fyulita/laboratorio-6-y-7/presentacion-Labo6.pdf

# Desarrollo de un sistema respirométrico para determinar la biodegradabilidad en compost

## Federico Yulita y Carolina Iacovone

## Directores Dr. Lucas Guz y Dra. Lucía Famá

## Presentación final de Laboratorio 6

### Laboratorio de Polímeros y Materiales Compuestos

Laboratorio VI

Introducción

Propuesta

Desarrollo

Prueba

Conclusiones

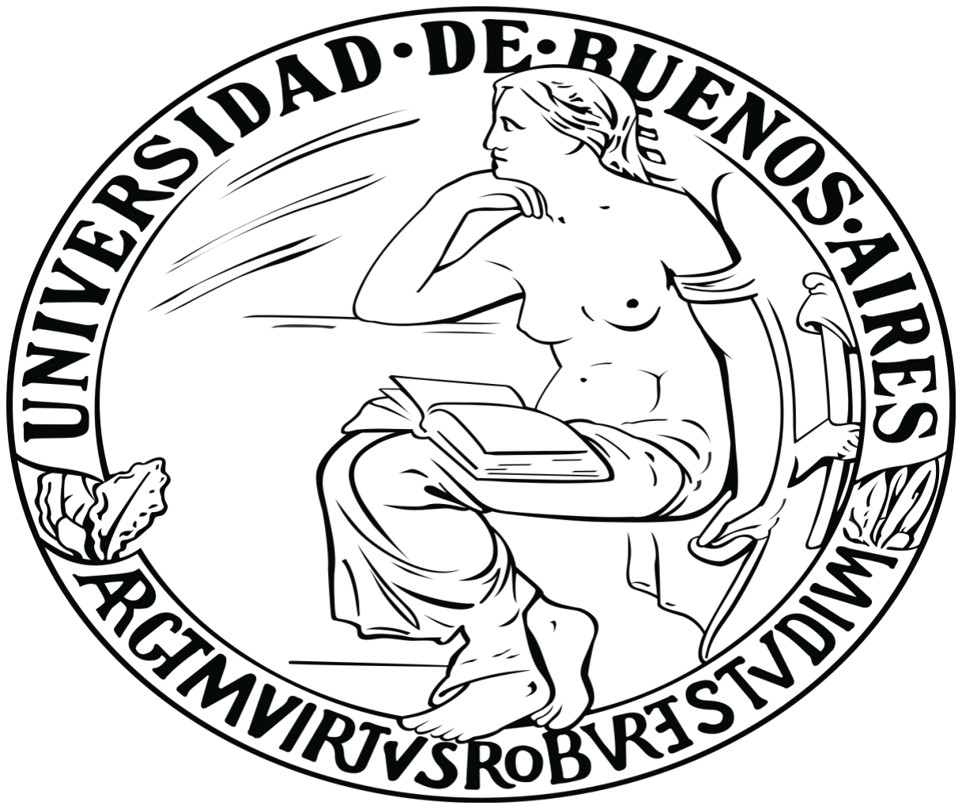
[picture p28: figure]
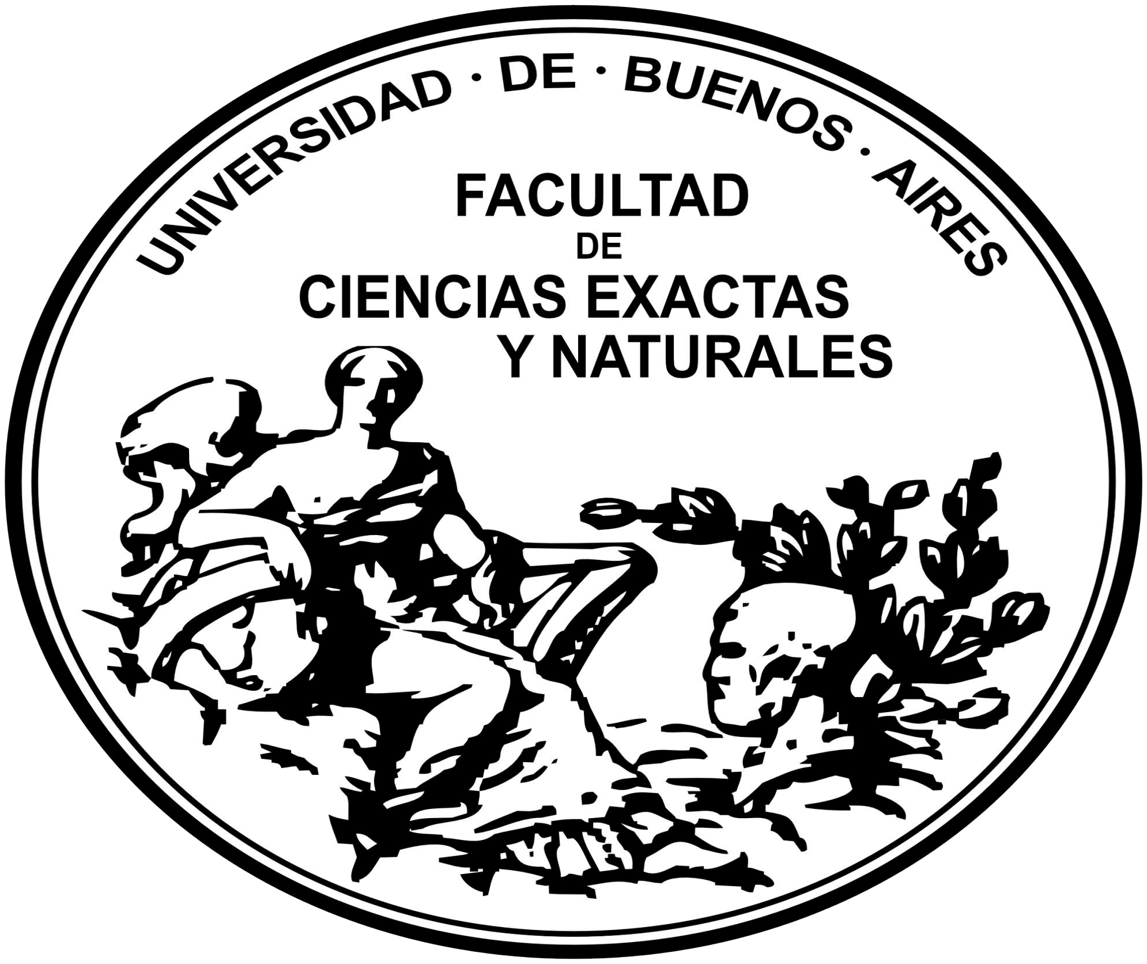
[picture p29: figure]
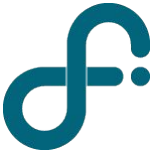
[picture p30: figure]

Introducción

Propuesta

Desarrollo

Prueba

Conclusiones

## Plásticos: problemática a escala mundial

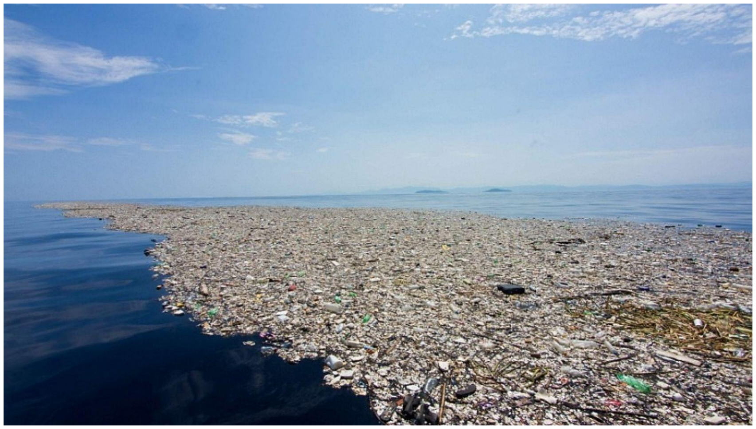
[picture p31: figure]

Isla de plásticos en el océano pacífico

Definición de polímero biodegradable¹
:
polímero susceptible a degradación mediante actividad biológica, acompañada por una disminución del peso molecular.

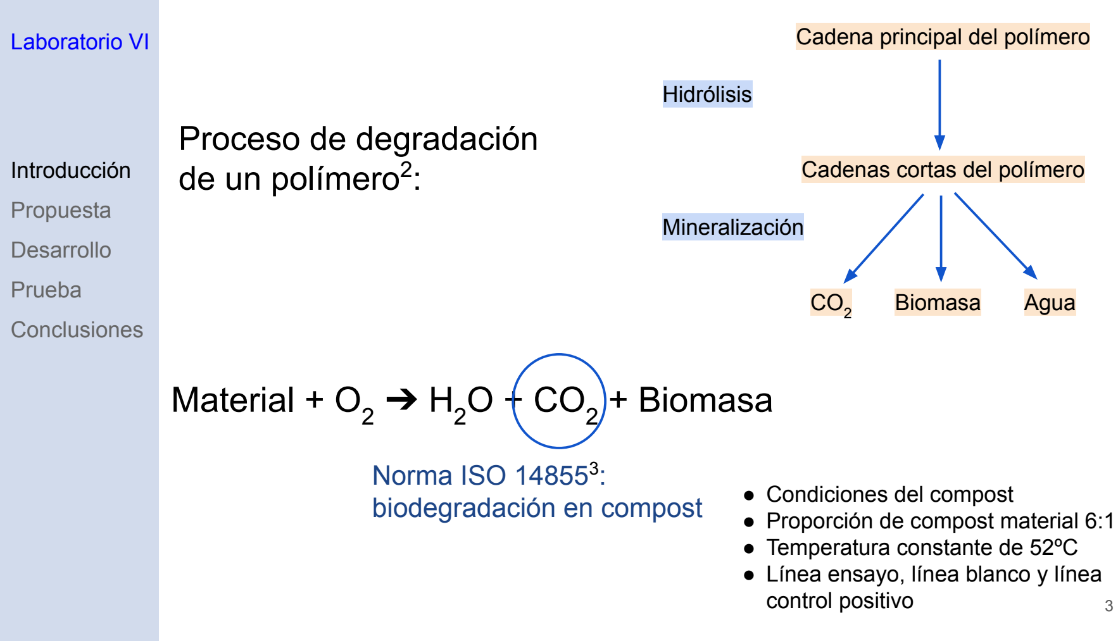
[picture p32: figure]
Introducción; Propuesta; Desarrollo; Prueba; Conclusiones; Cadena principal del polímero; Cadenas cortas del polímero; Biomasa; Agua; Hidrólisis; Mineralización; Proceso de degradación de un polímero² :; Material + O2 ➔ H2O + CO2; + Biomasa; Norma ISO 14855³; ● Proporción de compost material 6:1 ● Temperatura constante de 52ºC ● Línea ensayo, línea blanco y línea control positivo

### biodegradación en compost ● Condiciones del compost

Introducción

Propuesta

Desarrollo

Prueba

Conclusiones

Finalmente, un material es biodegradable si alcanza el 90% de la biodegradación del material en hasta 6 meses.⁴

## Objetivo: diseñar, fabricar y poner a punto un equipo capaz

de estudiar la biodegradabilidad de polímeros en compost.

Contexto actual en Argentina:
Se comercializan productos biodegradables → necesidad de una evaluación

## Serie Referencia

## Propuesta

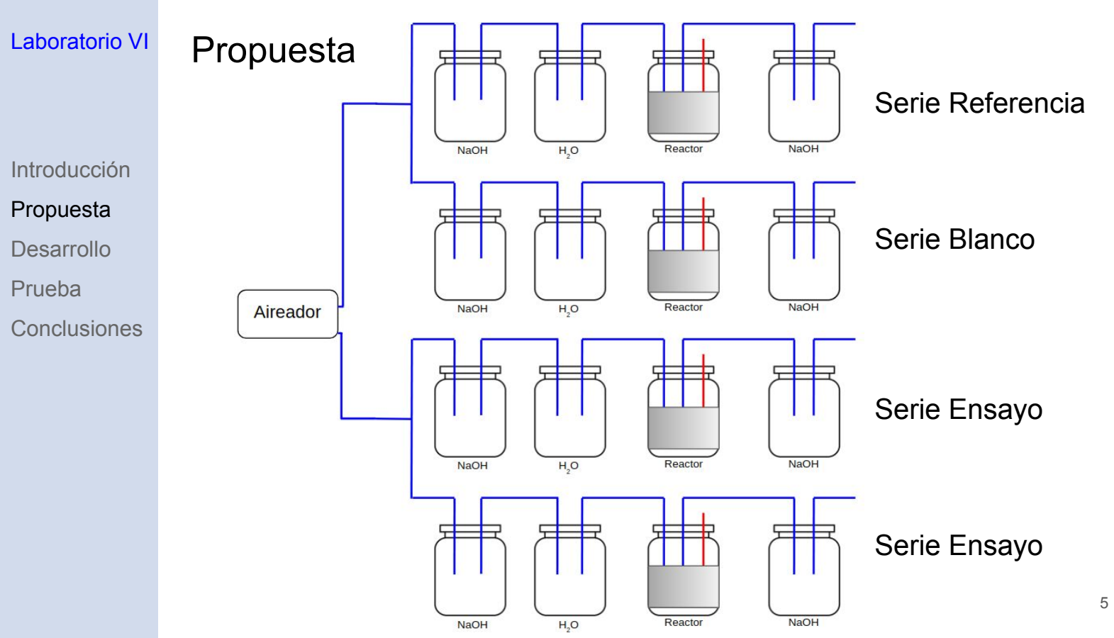
[picture p33: page 5]

Introducción

Propuesta

Desarrollo

Prueba

Conclusiones

## Serie Blanco

## Serie Ensayo

## Serie Ensayo

Introducción

Propuesta

Desarrollo

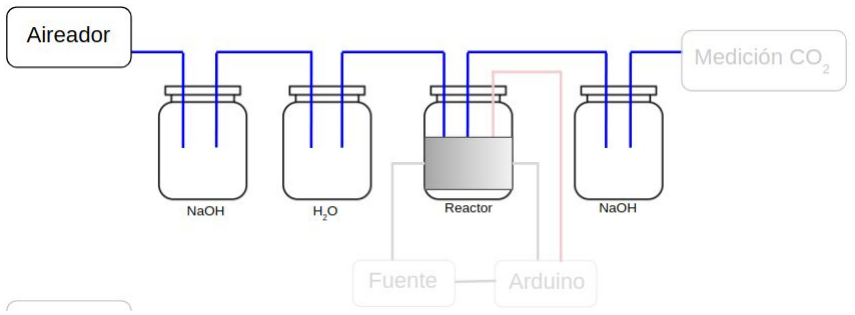
[picture p34: figure]

Prueba

Conclusiones

# Partes del equipo

- Seguimiento del aire
- Reactor
- Sistema térmico
- Medición de CO2

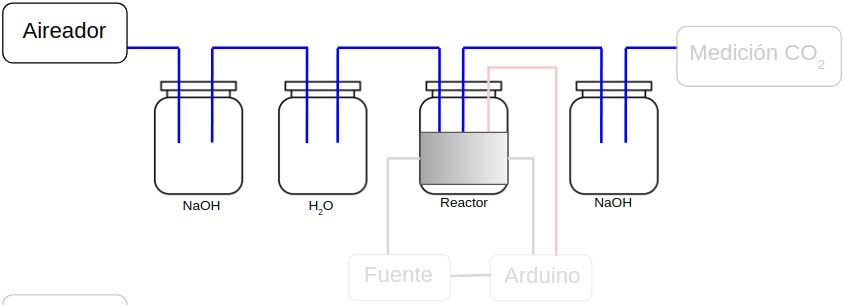
[picture p35: figure]

Introducción

Propuesta

Desarrollo

Prueba

Conclusiones

Seguimiento del aire

Introducción

Propuesta

Desarrollo

Prueba

Conclusiones

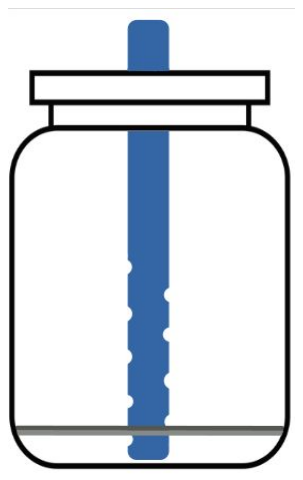
[picture p36: figure]
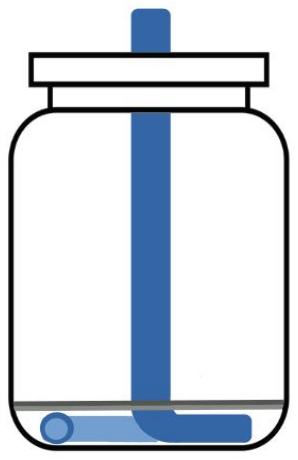
[picture p37: figure]

Configuración 1: agujeros en la manguera | Configuración 2: manguera formando un círculo en el fondo

Al Frasco de vidrio Schott se le colocaron piedritas en el fondo y dos mallas tipo mosquitero para hacer un colchón de aire. Luego, se realizaron 2 configuraciones para la circulación del aire:

Luego, se colocó el compost.

Reactor

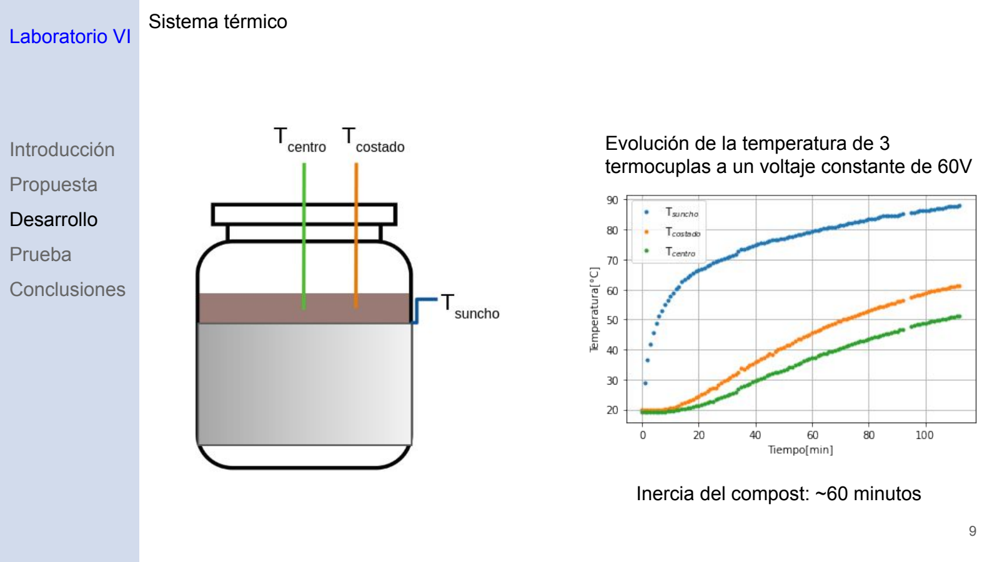
[picture p38: page 9]

Introducción

Propuesta

Desarrollo

Prueba

Conclusiones

Evolución de la temperatura de 3 termocuplas a un voltaje constante de 60V

Inercia del compost: ~60 minutos

Sistema térmico

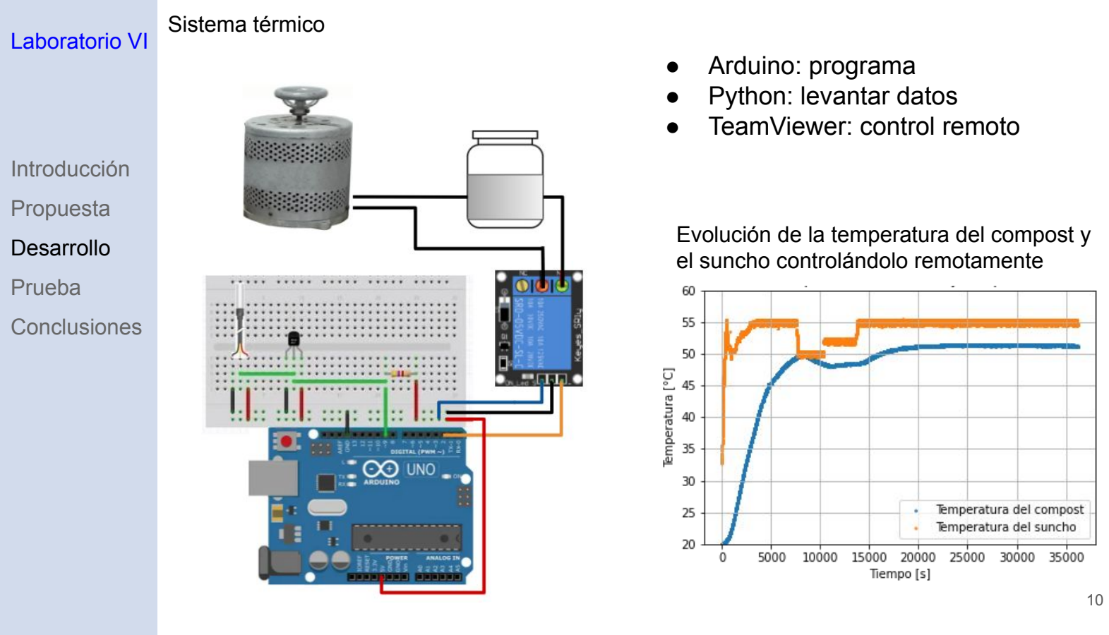
[picture p39: page 10]

Introducción

Propuesta

Desarrollo

Prueba

Conclusiones

Sistema térmico
- Arduino: programa
- Python: levantar datos
- TeamViewer: control remoto

Evolución de la temperatura del compost y el suncho controlándolo remotamente

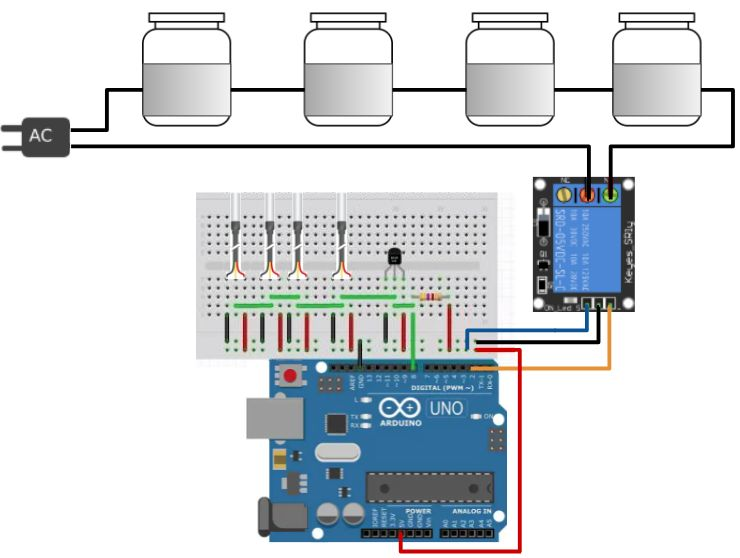
[picture p40: figure]

Introducción

Propuesta

Desarrollo

Prueba

Conclusiones

Sistema térmico: completo

## Equipo finalizado

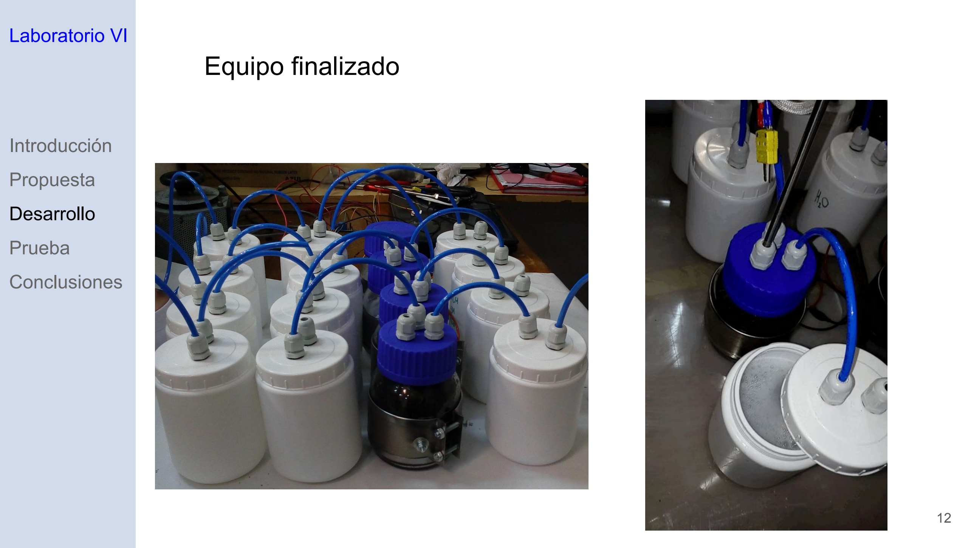
[picture p41: page 12]

Introducción

Propuesta

Desarrollo

Prueba

Conclusiones

## : Por titulación⁵

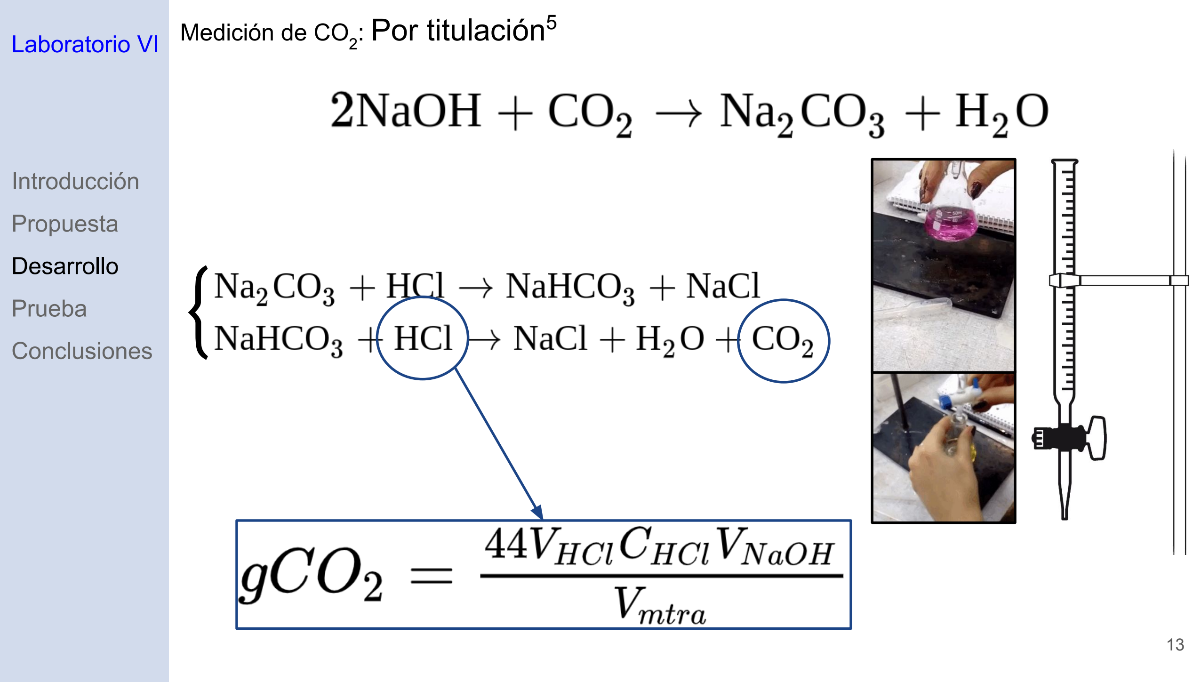
[picture p42: page 13]

Introducción

Propuesta

Desarrollo

Prueba

Conclusiones

Medición de CO2

{

Introducción

Propuesta

Desarrollo

Prueba

Conclusiones

## Puesta a punto: se realizaron dos simulaciones

## - Simulación con bicarbonato de sodio

Se simuló al compost con una solución de bicarbonato de sodio, esperando que se produzcan 1.78g de CO2
La trampa de NaOH capturó 0.4mL, es decir 1.40g de CO2

## - Simulación con pasto

Se colocó pasto en el compost y se dejó el equipo funcionando por 24hs. La trampa de NaOH capturó 0.2mL, es decir 0.70g de CO2

Introducción

Propuesta

Desarrollo

Prueba

Conclusiones

# Conclusiones

## - Se logró monitorear y controlar la temperatura del compost de

manera remota.

## - Las configuraciones de la manguera no presentaron diferencias

significativas.

## - Las simulaciones de captura de CO2

resultaron exitosas.
- Se logró construir el equipo.

## Proyección: analizar la biodegradabilidad de películas de almidón elaboradas por extrusión utilizando el equipo construido en laboratorio 6

# ¡Muchas gracias!

# Bibliografía

1
IUPAC. Compendium of Chemical Terminology, 2nd ed. (the "Gold Book"). Compilado por A. D. McNaught y A. Wilkinson. Blackwell Scientific Publications, Oxford (1997). Versión online (2019-) creado por S. J. Chalk. ISBN 0-9678550-9-8. https://doi.org/10.1351/goldbook.

2E. Castro Aguirre, Design and construction of a medium-scale automated direct measurement respirometric system to assess aerobic biodegradation of polymers, Michigan State University, 2013.

3
ISO/DIS 14855-1. Determination of the Ultimate Aerobic Biodegradability and Disintegration of Plastic Materials under Controlled Composting Conditions—Method by Analysis of Evolved Carbon dioxide.

4EN 13432:2000. Packaging - Requirements for packaging recoverable through composting and biodegradation - Test scheme and evaluation criteria for the final acceptance of packaging.

5G. Kale, R. Auras, S. P. Singh, R. Narayan, Biodegradability of polylactide bottles in real and simulated composting conditions, Polymer Testing 26 (2007) 1049–1061.

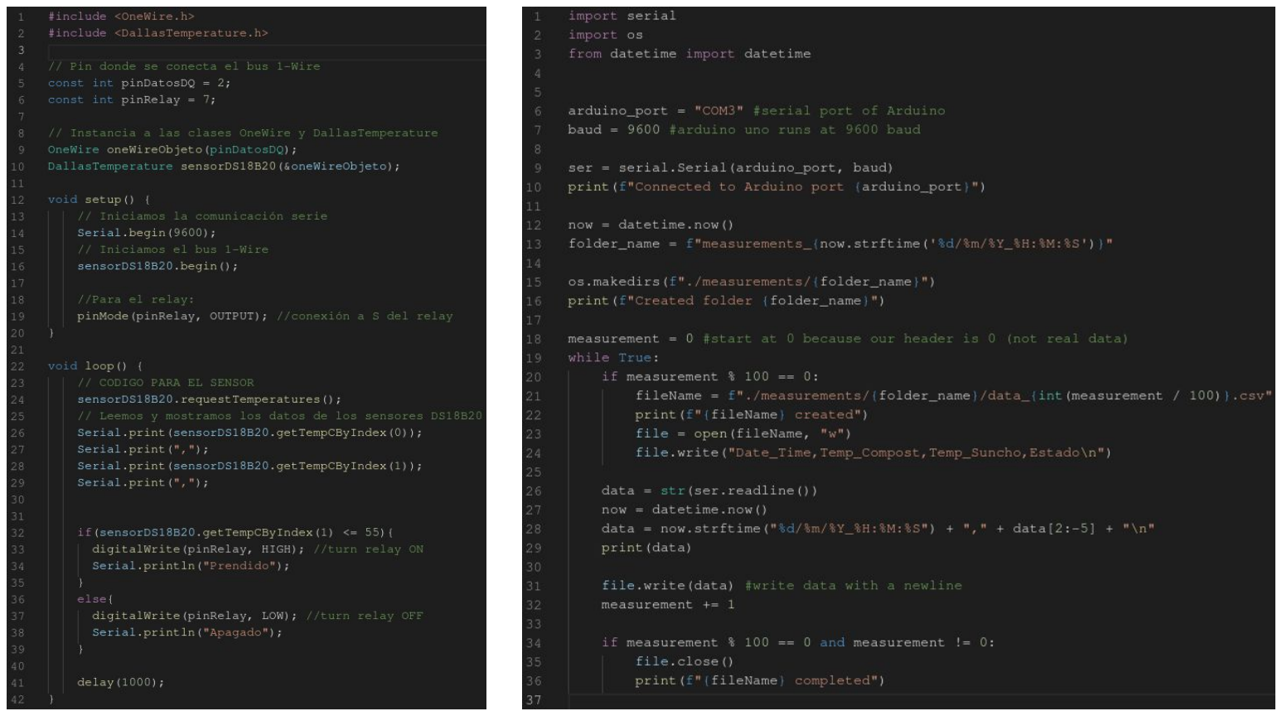
[picture p43: page 18]
