fyulita/laboratorio-6-y-7/Facturas/factura_arduino.pdf

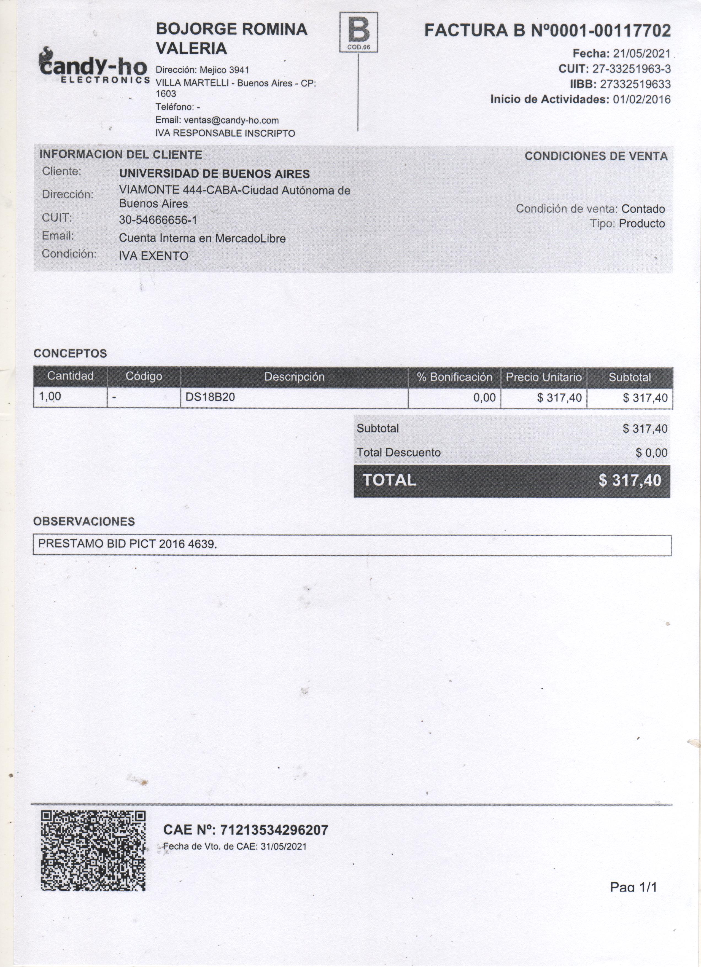
[picture p54: page 1]
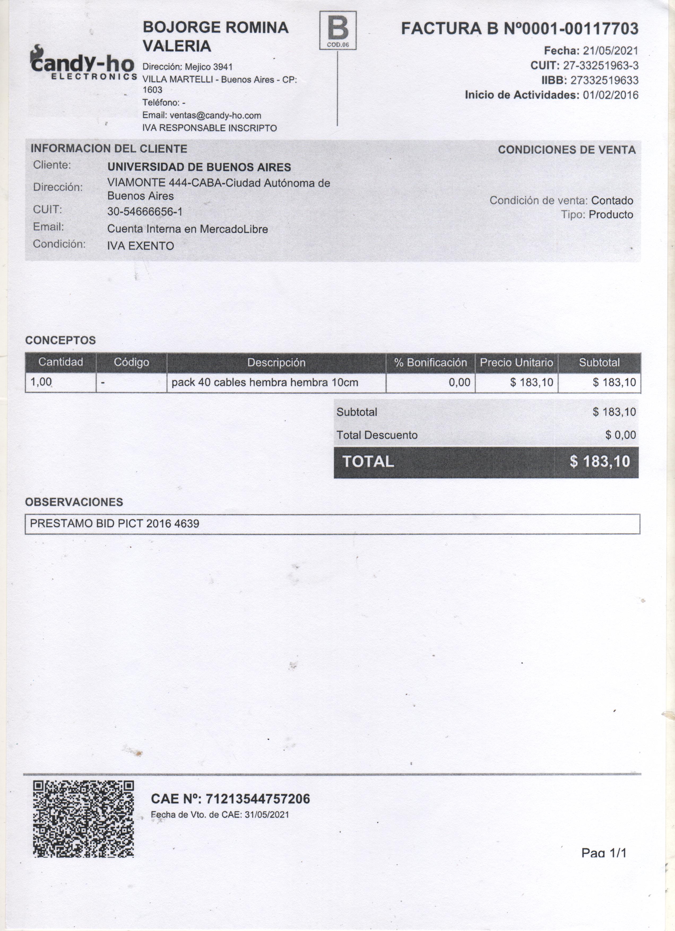
[picture p55: page 2]
