fyulita/laboratorio-6-y-7/Facturas/Frascos plastico - factura.pdf

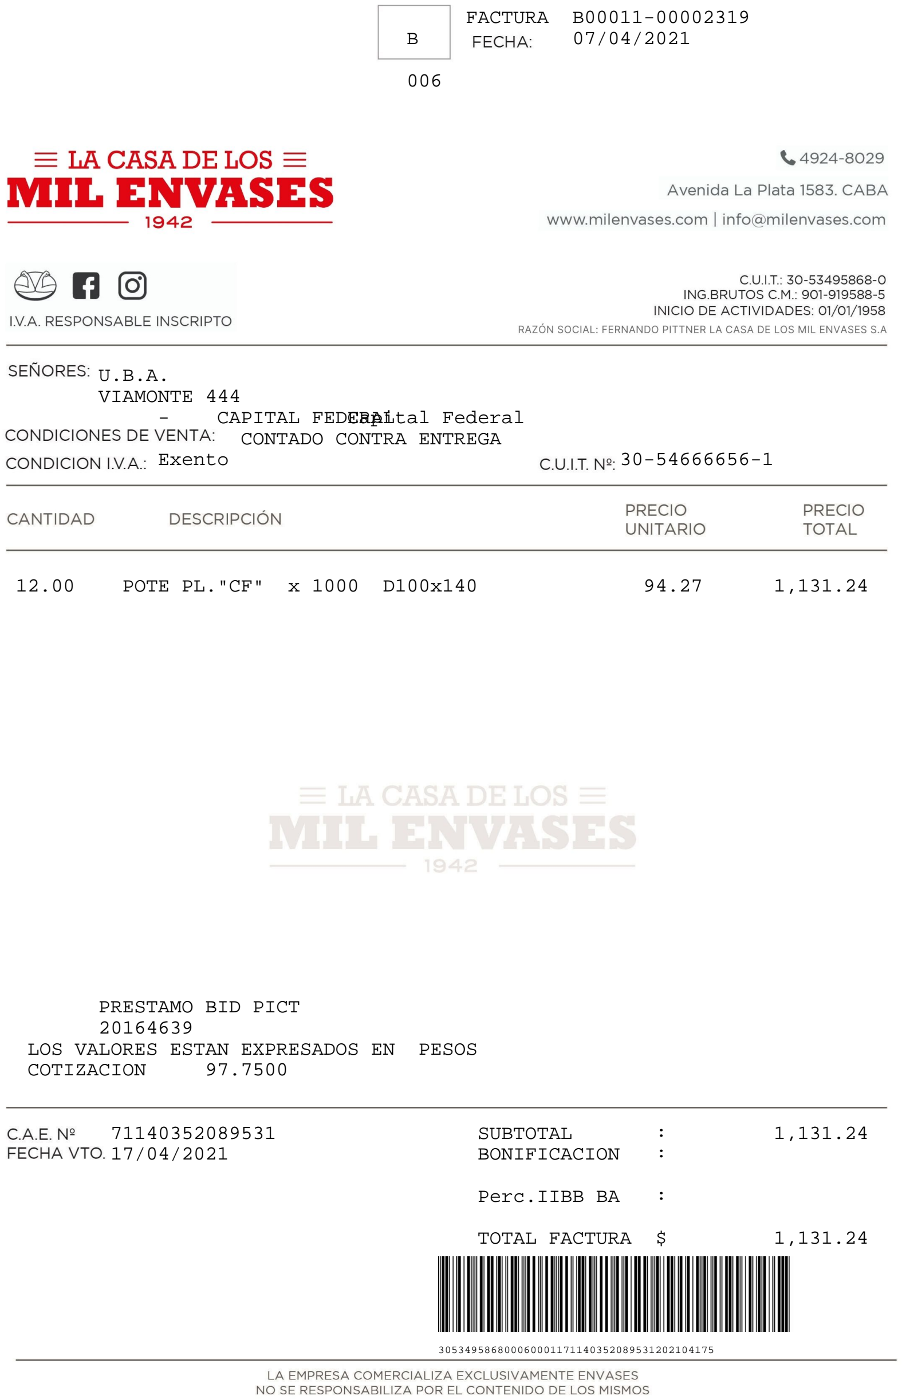
[picture p56: page 1]

FACTURA B00011-00002319
B | 07/04/2021

006

U.B.A.
VIAMONTE 444
- CAPITAL FEDECRaApLital Federal
CONTADO CONTRA ENTREGA
Exento | 30-54666656-1
12.00 | POTE PL."CF" x 1000 D100x140 | 94.27 | 1,131.24

PRESTAMO BID PICT
20164639
LOS VALORES ESTAN EXPRESADOS EN PESOS
COTIZACION | 97.7500
71140352089531 | SUBTOTAL | : | 1,131.24
17/04/2021 | BONIFICACION | :
| Perc.IIBB BA | :
TOTAL FACTURA $ | 1,131.24

305349586800060001171140352089531202104175
