fyulita/laboratorio-6-y-7/Facturas/ManguerayConcetor - Datos bancarios.pdf

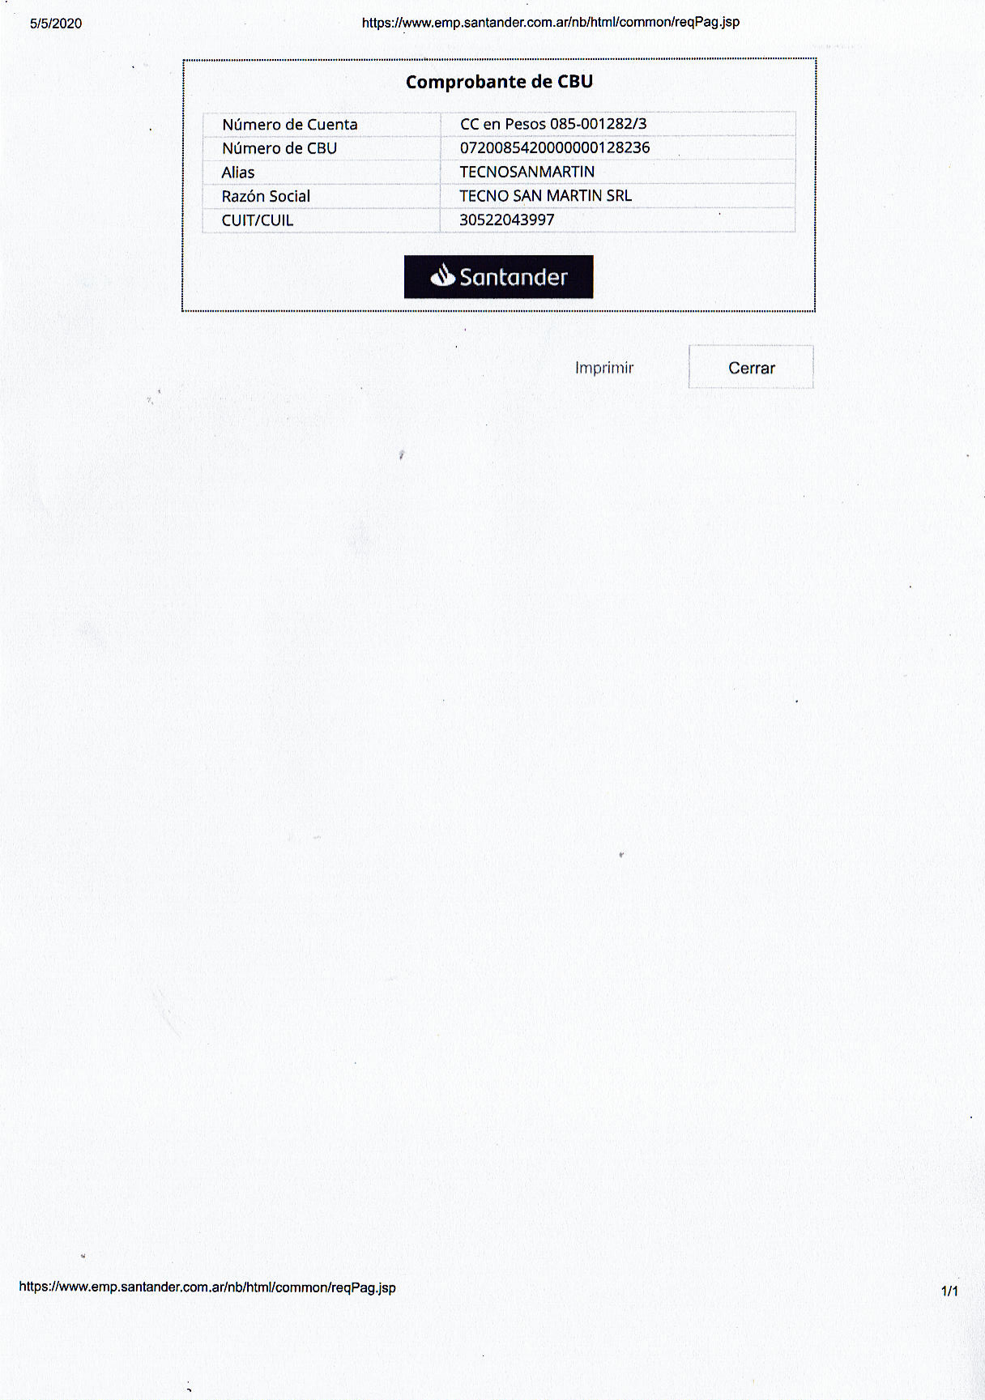
[picture p57: page 1]
