fyulita/laboratorio-6-y-7/Facturas/ManguerayConectores - Factura.pdf

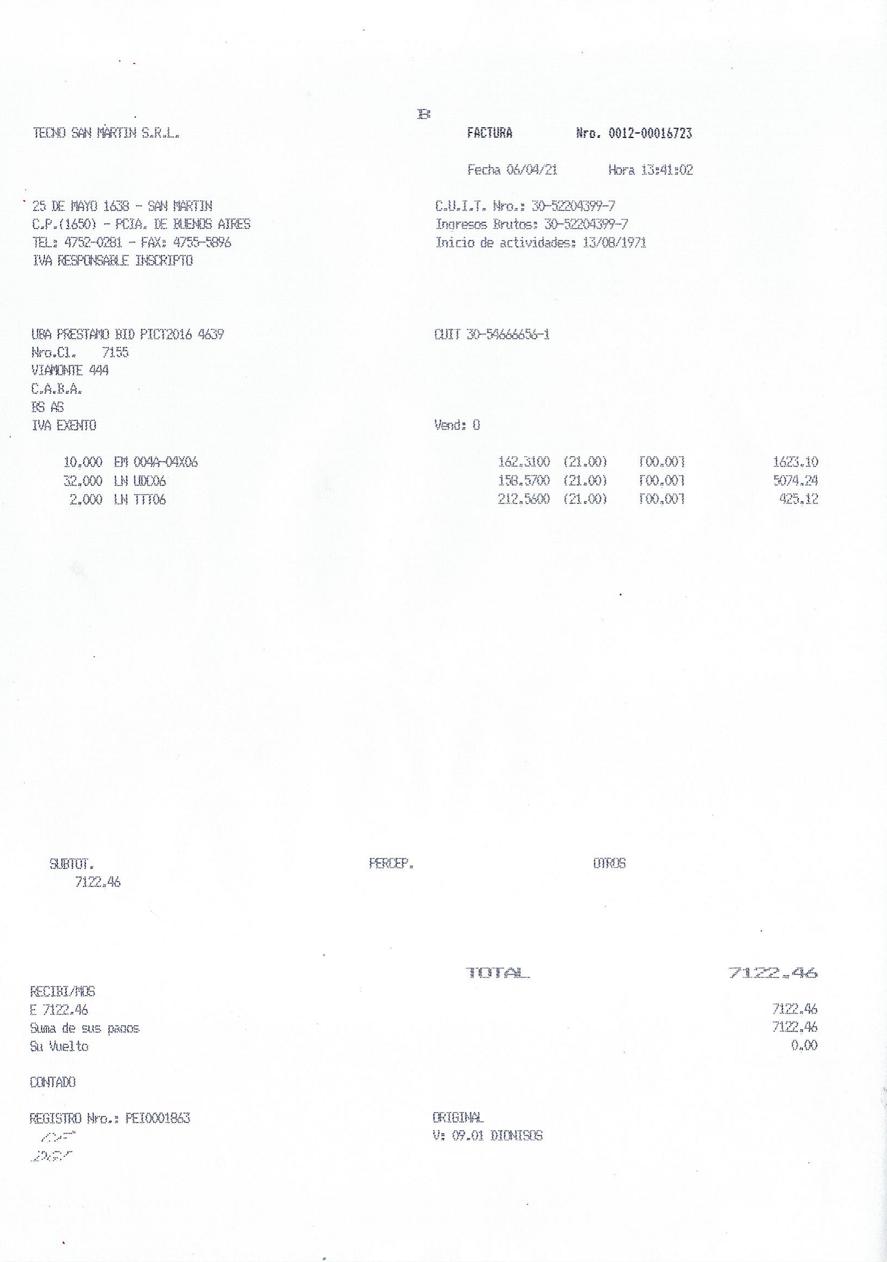
[picture p58: page 1]
