fyulita/laboratorio-6-y-7/Arduino/biodeg_sensor_primer-medicion-restado.png

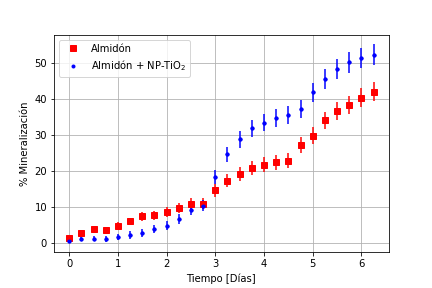
Arduino/biodeg_sensor_primer-medicion-restado.png
