fyulita/laboratorio-6-y-7/Arduino/biodeg_sensor_segunda-medicion-restado.png

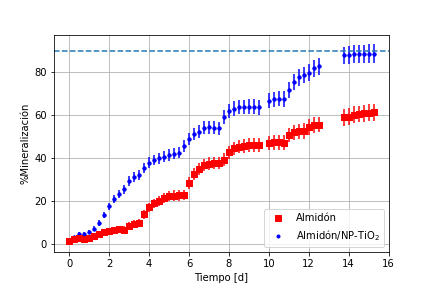
Arduino/biodeg_sensor_segunda-medicion-restado.png
