fyulita/laboratorio-6-y-7/Arduino/co2_acumulado-sensor.png

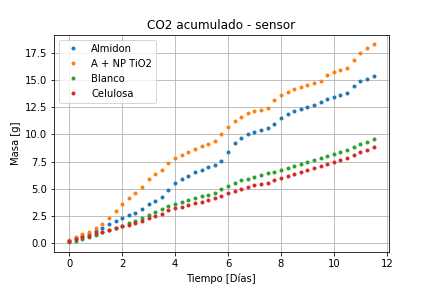
Arduino/co2_acumulado-sensor.png
