fyulita/laboratorio-6-y-7/download.png

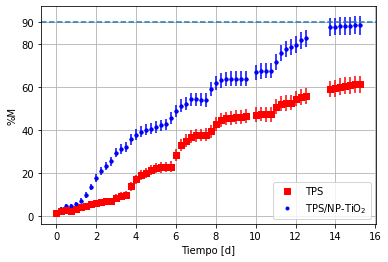
download.png
