fyulita/laboratorio-6-y-7/Imagenes/arduino2.png

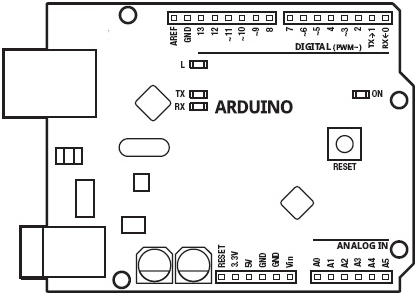
Imagenes/arduino2.png
