fyulita/laboratorio-6-y-7/Imagenes/arduino3.png

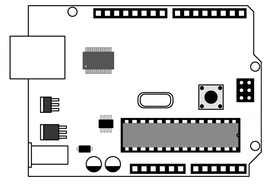
Imagenes/arduino3.png
