fyulita/laboratorio-6-y-7/Imagenes/equipo4.png

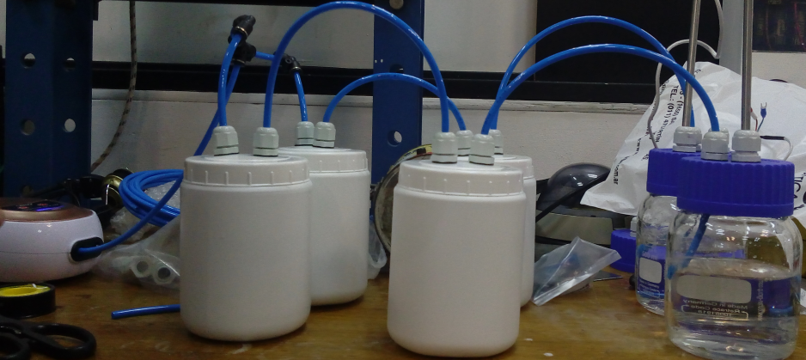
Imagenes/equipo4.png
