fyulita/laboratorio-6-y-7/Imagenes/equipo.jpeg

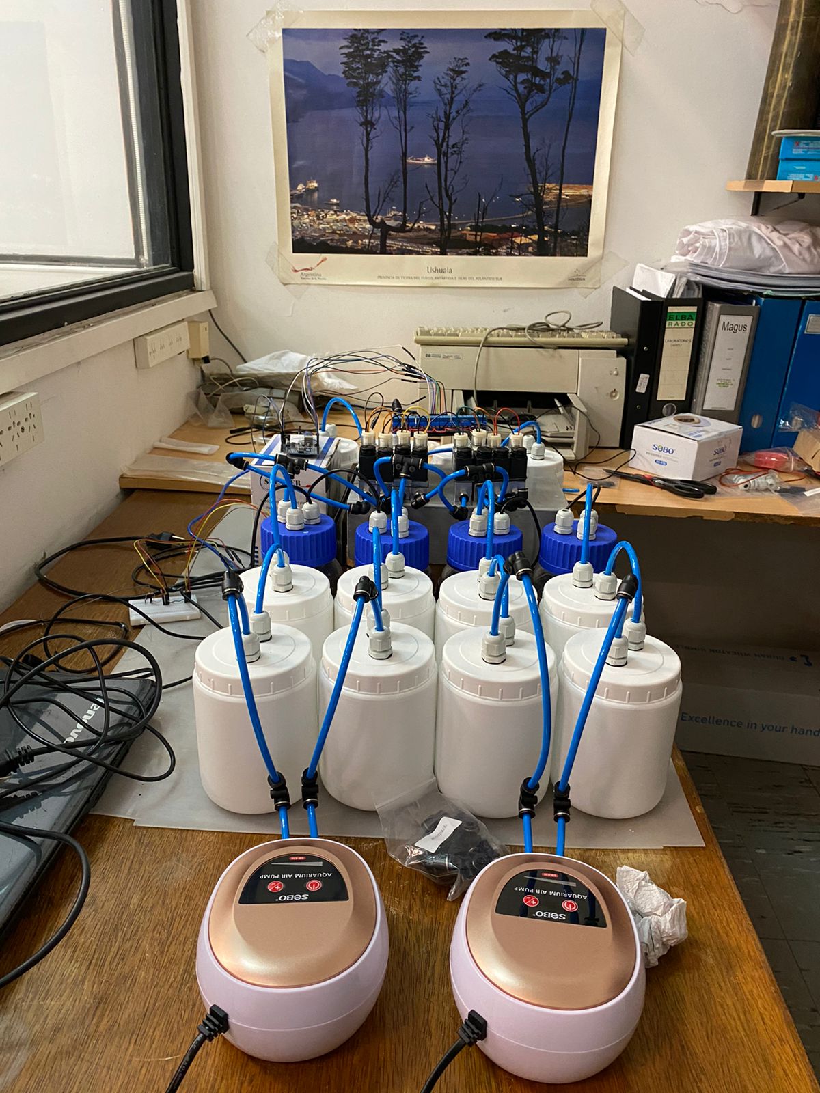
Imagenes/equipo.jpeg
