fyulita/laboratorio-6-y-7/Imagenes/esquema_5T.png

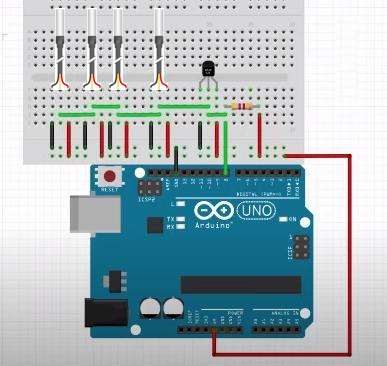
Imagenes/esquema_5T.png
