fyulita/laboratorio-6-y-7/Imagenes/esquema_reactor.png

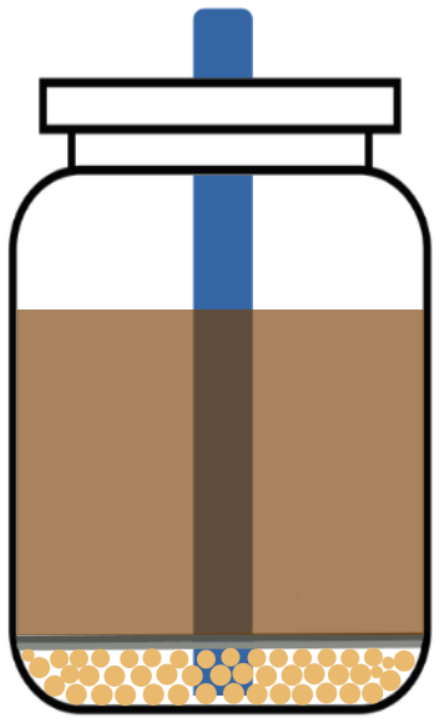
Imagenes/esquema_reactor.png
