fyulita/laboratorio-6-y-7/Imagenes/esquema_T1.png

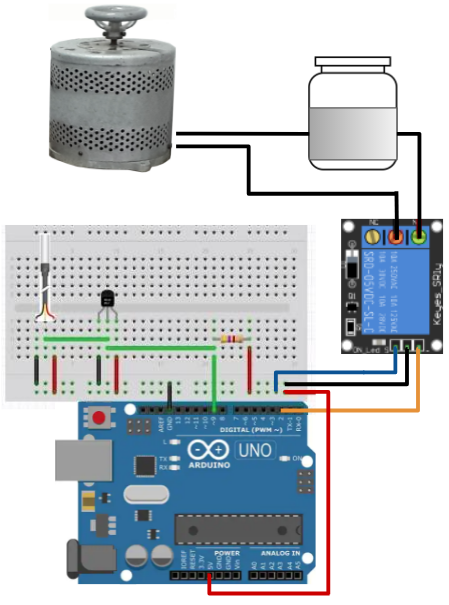
Imagenes/esquema_T1.png
