fyulita/laboratorio-6-y-7/Imagenes/integracion.png

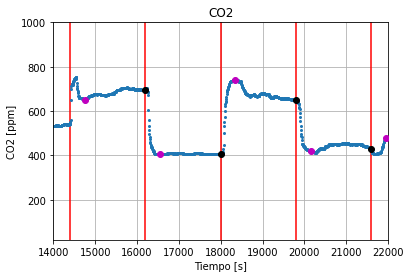
Imagenes/integracion.png
