fyulita/laboratorio-6-y-7/Imagenes/MHZ19.png

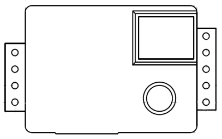
Imagenes/MHZ19.png
