fyulita/laboratorio-6-y-7/Imagenes/presentacion/1.png

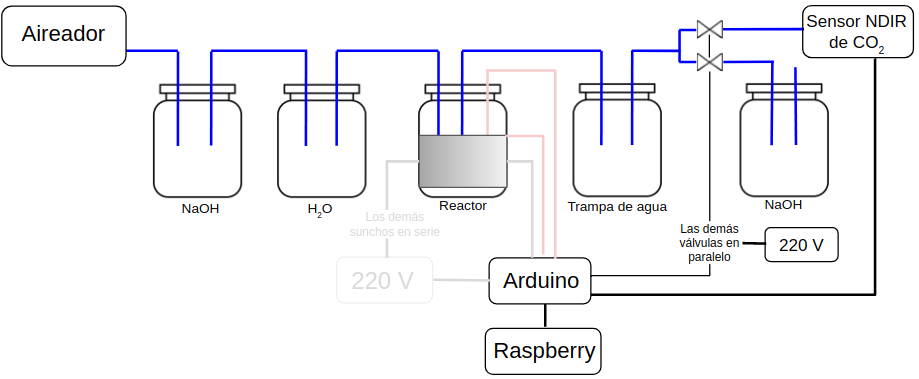
Imagenes/presentacion/1.png
