fyulita/laboratorio-6-y-7/Imagenes/presentacion/ballena.jpg

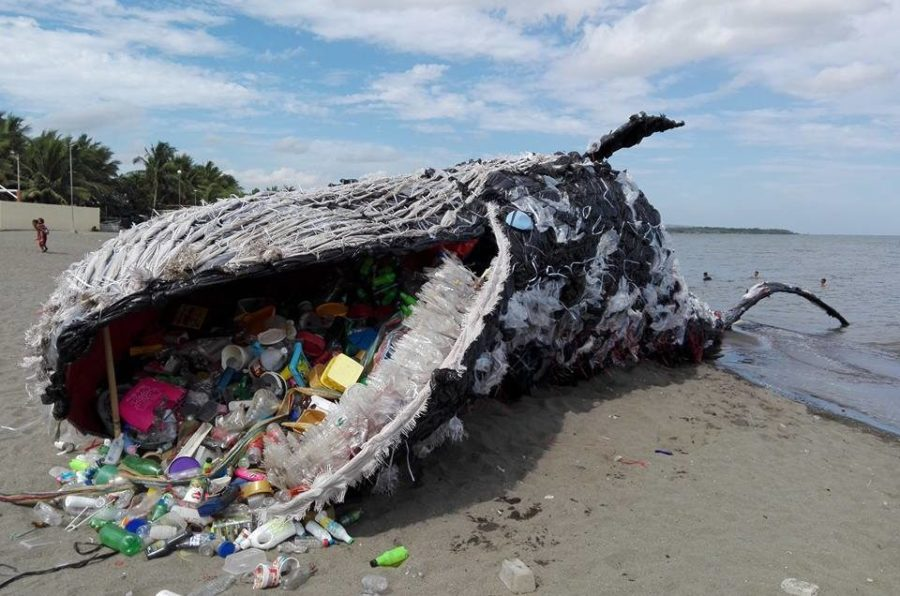
Imagenes/presentacion/ballena.jpg
