fyulita/laboratorio-6-y-7/Imagenes/presentacion/biodeg.png

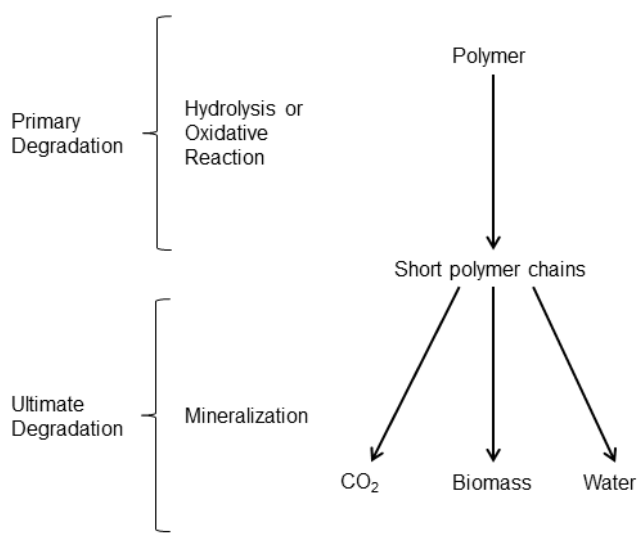
Imagenes/presentacion/biodeg.png
