fyulita/laboratorio-6-y-7/Imagenes/presentacion/c1.png

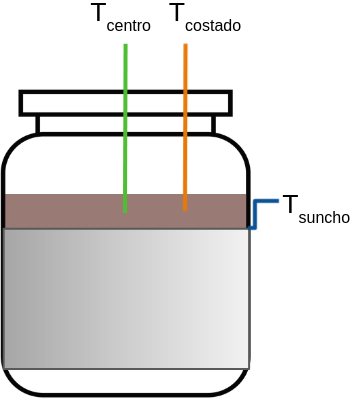
Imagenes/presentacion/c1.png
