fyulita/laboratorio-6-y-7/Imagenes/presentacion/reactor1.png

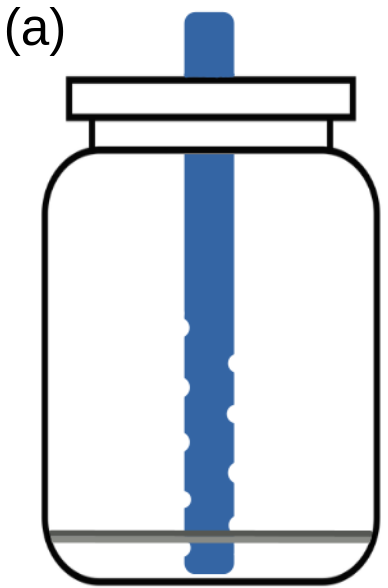
Imagenes/presentacion/reactor1.png
