fyulita/laboratorio-6-y-7/TGA/TGA.png

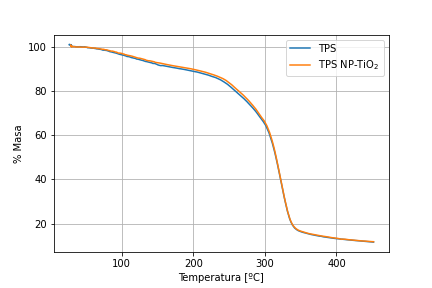
TGA/TGA.png
