fyulita/laboratorio-6-y-7/Titulacion/primer_medicion.png

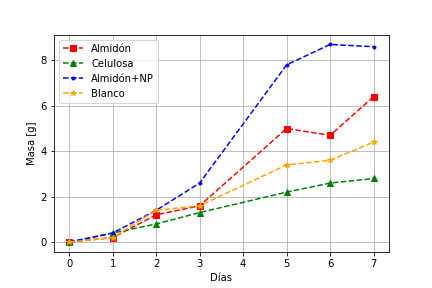
Titulacion/primer_medicion.png
