fyulita/laboratorio-6-y-7/Titulacion/segunda_medicion_restado.png

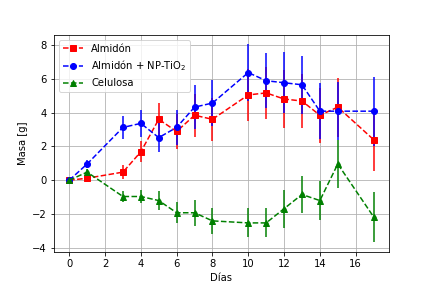
Titulacion/segunda_medicion_restado.png
