fyulita/laboratorio-6-y-7/Titulacion/titulacion-primera_medicion.png

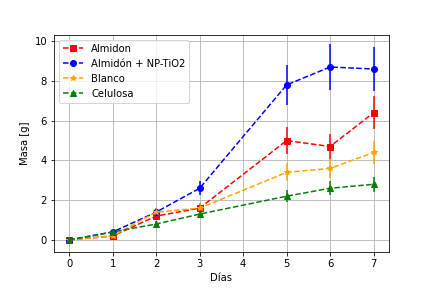
Titulacion/titulacion-primera_medicion.png
