fyulita/laboratorio-6-y-7/Untitled.png

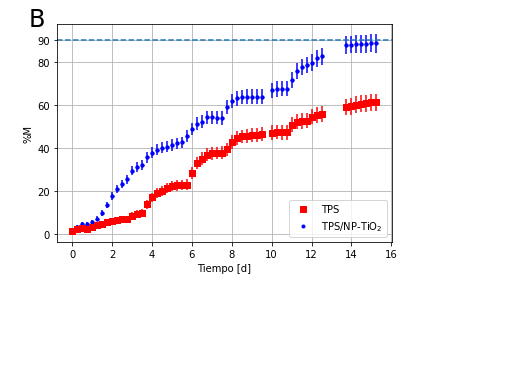
Untitled.png
