fyulita/laboratorio-6-y-7/WVP/curva_muestra4.png

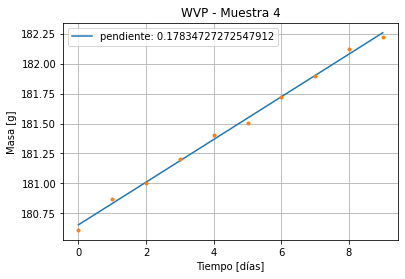
WVP/curva_muestra4.png
