fyulita/laboratorio-6-y-7/WVP/curva_muestra8.png

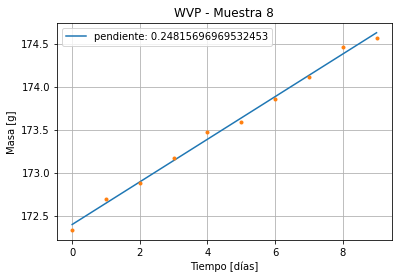
WVP/curva_muestra8.png
