fyulita/laboratorio-6-y-7/WVP/resumen_curva_impares.png

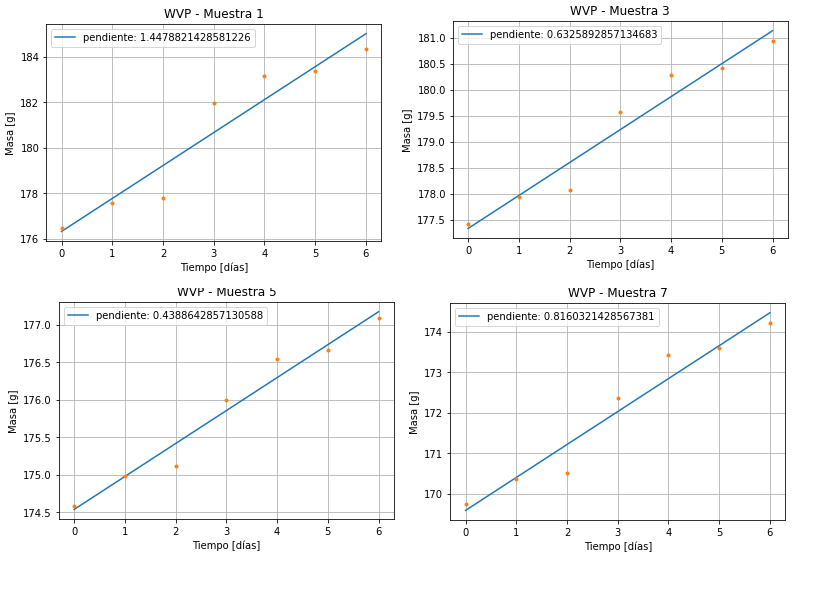
WVP/resumen_curva_impares.png
