fyulita/laboratorio-6-y-7/WVP/resumen_curva_pares.png

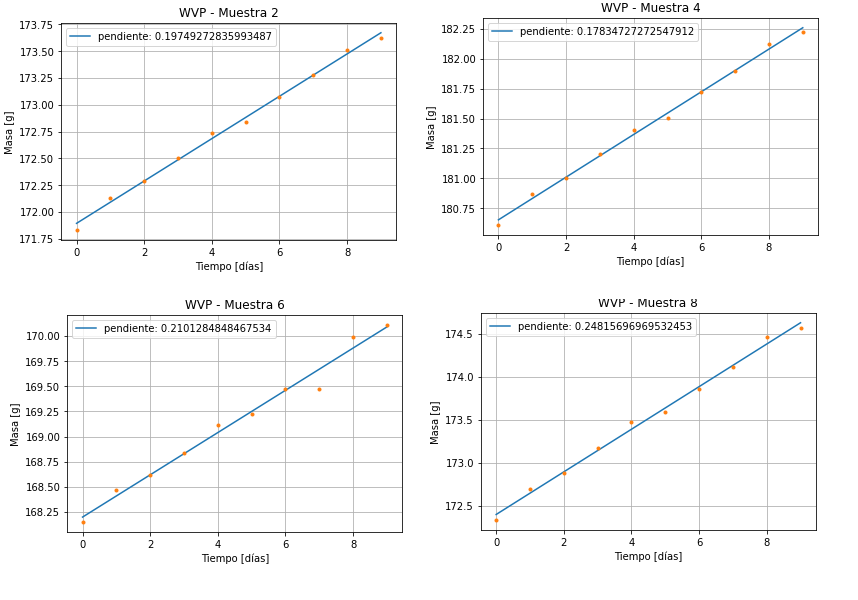
WVP/resumen_curva_pares.png
