fyulita/laboratorio-6-y-7/TEST3/Resumen.odp

Medición que se debe realizar, según norma.

En verde si está bien, en naranja si está más o menos, en rojo si no está

(6)

Número de referencia en “NOTA”.

Allí se especifica la carpeta, hora, estado de medición, etc.

Día 1 Día 2 Día 3 Día 4

23/03

00 hs

24/03

00 hs

25/03

00 hs

26/03

00 hs

22/03

20hs

06 12 18

06 12 18

20hs

06 12 18 06 12 18

20hs

00 h 06 h 11 h 15 h 2 h 6.30 17 h 01 h 5h 10.30h 15.30 01:30 6:30 11:30

20 h

Mudanza

Medición media mala, a ojo

(1)

Por alguna extraña razón, midió 0 ppm.

Medición media mala, a ojo

(2)

Medición correcta.

Medición correcta. 1,2,3 midieron bien, el 4to midió 0ppm pero estaba despierta y lo medí aparte y los junté.

Medición correcta.

Se me apagó la compu en medio de la medición

Medición correcta y hermosa.

Medición correcta y hermosa.

Medición correcta y hermosa.

Medición correcta y hermosa.

Medición correcta y hermosa.

Medición correcta y hermosa.

Medición correcta y hermosa.

Medición correcta y hermosa.

(3)

(5)

(6)

21h

Medición correcta y hermosa.

(6)

(6)

(7) (7) (7) (7) (7) (8)

20.30

Medición correcta y hermosa.

(4)

10 am

Riego y fotos

(6)

(7)

sigue -->

## Slide 2

Día 5 Día 6 Día 7 Día 8

27/03

00 hs

28/03

00 hs

29/03

00 hs

30/03

00 hs

18 06 12 18 06 12 18 06 12 18 06 12

18 h 00 h 06 h 12 h 18 h 8 h 14 h 20 h 02 h 08h 14 h 20 h 02 h 08 h 14h

(9) (10) (10) (10) (10) (10) (10) (10) (10) (10)

Medición correcta.

Medición correcta.

Medición correcta.

Medición correcta.

Medición correcta.

Falló la medición, marcó 0ppm

Medición correcta.

Medición correcta.

Medición correcta.

Medición correcta.

Medición correcta.

Medición correcta.

Medición correcta.

Medición correcta.

Medición correcta.

Medición correcta.

(8) (8) (8) (8) (8)

## Slide 3

Día 8 Día 9 Día 10 Día 11

31/03

00 hs

01/04

00 hs

02/04

00 hs

03/04

00 hs

18 06 12 18 06 12 18 06 12 18 06 12

20 h 02 h 08 h 14 h 20 h 02h 8 h 14 h 20 h 02 h 08h 16.30 h 23.30 13.30h

(11) (11) (11) (11) (11) (11) (12) (13) (14) (10)

Falló la medición, marcó 0ppm

Falló la medición, marcó 0ppm

Falló la medición, marcó 0ppm

Falló la medición, marcó 0ppm

Falló la medición, marcó 0ppm

Medición correcta.

Medición correcta.

Medición correcta.

Medición correcta.

Medición correcta.

Medición correcta.

Medición perdida.

Medición correcta.

Medición correcta.

Medición perdida. Marcó 0ppm en la última línea

Medición correcta.

## Slide 4

Día 12 Día 13 Día 14 Día 15

04/04

00 hs

05/04

00 hs

06/04

00 hs

07/04

00 hs

18 06 12 18 06 12 18 06 12 18 06 12

18.30 h 00.30 h 6.30 12.30 18.30 h 00.30 h 06.30h 12.30 h 18.30 h 23.30 h 05.30 h 11.30h 17.30 23.30 05.30 11.30

(15) (15) (16) (16) (16) (16) (16) (16) (17) (17) (17) (17) (17) (17) (17)

15.30 h 21.30 h 03.30 h 09:30 h 15:30 h 02.30 08.30 14.30 20.30 02.30 08.30 14.30

(16) (16) (16) (16) (16) (17) (17) (17) (17) (17) (17)

Medición correcta.

Medición correcta.

Falló la medición, marcó 0ppm

Falló la 4ta línea, marcó 0ppm, pero dejé las demás igual. Sino SACAR

Medición correcta.

Medición correcta.

Medición correcta.

Medición correcta.

Medición correcta.

Medición correcta.

Medición correcta.

Medición correcta.

Medición correcta.

Medición correcta.

Medición correcta.

Medición correcta.

Medición correcta.

21.30 h 03.30

Medición correcta.

(15)

Medición correcta.

Medición correcta.

Medición correcta.

Medición correcta.

Medición correcta.

Medición correcta.

Medición correcta.

Medición correcta.

Medición correcta.

Medición correcta.

Medición correcta.

Medición correcta.

## Slide 5

Día 16 Día 17 Día 18 Día 19

08/04

00 hs

09/04

00 hs

10/04

00 hs

11/04

00 hs

18 06 12 18 06 12 18 06 12 18 06 12

17.30 h 00.30 h 11.30 17.30 h 23.30 h 05.30h 11.30 h 17.30 h 06.30 h 12.30h 20.30 00 07.45 13.45

(17) (18) (19) (19) (19) (19) (19) (19) (20) (20) (20) (21) (21)

14.30 h 20.30 h 02.30 h 08:30 h 14:30 h 03.30 09.30 15.30 10.45

(19) (19) (19) (19) (19) (20) (20) (20) (21)

Medición correcta.

Medición correcta.

Falló la medición, marcó 0ppm

Medición correcta.

Medición correcta.

Medición correcta.

Medición correcta.

Medición correcta.

Medición correcta.

Falló la medición, marcó 0ppm

Medición correcta.

Medición correcta.

Medición correcta.

Medición correcta.

Falló la medición, marcó 0ppm

Medición correcta.

Medición correcta.

21.30 h

Medición correcta.

(18)

Medición correcta.

Medición correcta.

Medición correcta.

Medición correcta.

Medición correcta.

Medición correcta.

Medición correcta.

Medición correcta.

## Slide 6

Día 20 Día 21 Día 22 Día 23

12/04

00 hs

13/04

00 hs

14/04

00 hs

15/04

00 hs

18 06 12 18 06 12 18 06 12 18 06 12

18 h 00 h 06 h 12 23.10 h 06.10h 13 h 19 h 22.45 04.45 10.45 19h 01h 11

(22) (23) (23) (24) (24) (25) (25) (26) (26) (26) (27) (27) (28)

20.10 h 03.10 h 08:30 h 16 h 01.45 07.45 16 22 14

(24) (24) (24) (25) (26) (26) (27) (27) (28)

Medición correcta.

Medición correcta.

Medición correcta.

Falló la medición, marcó 0ppm

Falló la medición, marcó 0ppm

Medición correcta.

Medición correcta.

Medición correcta.

Medición correcta.

Medición correcta.

Medición correcta.

Medición correcta.

Medición correcta.

Medición correcta.

Falló la medición, marcó 0ppm

Medición correcta.

Medición correcta.

21 h 03 h 09 h

(23) (23) (23)

Medición correcta.

Medición correcta.

Medición correcta.

Medición correcta.

Medición correcta.

Medición correcta.

Medición correcta.

Medición correcta.

Medición correcta.

Medición correcta.

Medición correcta.

## Slide 7

Día 24 Día 25 Día 26 Día 27

16/04

00 hs

17/04

00 hs

18/04

00 hs

19/04

00 hs

18 06 12 18 06 12 18 06 12 18 06 12

17 h 23 h 05 h 11 17h 23 h 05h 11 h 17 h 00.30 06.30 12.30

(28) (28) (28) (28) (28) (28) (28) (28) (28) (29) (29) (29)

14 20 h 02 h 08 h 14 h 20h 21.30 03.30 09.30 15.30

(28) (28) (28) (28) (28) (28) (28) (28) (28)

Medición correcta.

Medición correcta.

Medición correcta.

Medición correcta.

Medición correcta.

Medición correcta.

Medición correcta.

Medición correcta.

Medición correcta.

Falló la medición, marcó 0ppm

Medición correcta.

Falló la medición, marcó 0ppm

Falló la medición, marcó 0ppm

Falló la medición, marcó 0ppm

Medición correcta.

Medición correcta.

Medición correcta.

Medición correcta.

Medición correcta.

20 h 02 h 08 h

Medición correcta.

Medición correcta.

Medición correcta.

Medición correcta.

Medición correcta.

Medición correcta.

Medición correcta.

Medición correcta.

Medición correcta.

Medición correcta.

(29) (29) (29) (29)

## Slide 8

Día 28 Día 29 Día 30 Día 31

20/04

00 hs

21/04

00 hs

22/04

00 hs

23/04

00 hs

18 06 12 18 06 12 18 06 12 18 06 12

18.30 h 00.30 h 06.30 h 00h 06h 11.40 17.40 23.40 12.20 18.20 00.20 06.20 12.20

(29) (29) (29) (30) (30) (31) (31) (31) (32) (32) (32) (32) (32)

03 h 14.40 h 20.40 02.40 09.20 15.20 21.20 03.20 09.20 15.20

(29) (29) (30) (31) (31) (31) (32) (32) (32) (32) (32) (32)

Medición correcta.

Medición correcta.

Medición correcta.

Falló la medición, marcó 0ppm

Falló la medición, marcó 0ppm

Medición correcta.

Medición correcta.

Medición correcta.

Medición correcta.

Medición correcta.

Falló la medición, marcó 0ppm

Medición correcta.

Medición correcta.

Medición correcta.

Medición correcta.

Medición correcta.

Medición correcta.

Medición correcta.

21.30 h 03.30 h

Medición correcta.

Medición correcta.

Medición correcta.

Medición correcta.

Medición correcta.

Medición correcta.

Medición correcta.

Medición correcta.

Medición correcta.

Medición correcta.

## Slide 9

Día 32 Día 33 Día 34 Día 35

24/04

00 hs

25/04

00 hs

26/04

00 hs

27/04

00 hs

18 06 12 18 06 12 18 06 12 18 06 12

18.20 h 00.20 h 06.20 h 12.20 18.20 00.20h 06.20h 12.20 18.20 00.20 06.20 12.20 18.20

(32) (32) (32) (32) (32) (32) (32) (32) (32) (32) (32) (329 (32) (32)

03.20 h 09.20 15.20 h 21.20 03.20 09.20 15.20 21.20

(32) (32) (32) (32) (32) (32) (32) (32) (32) (32) (32) (32) (32)

Medición correcta.

Medición correcta.

Medición correcta.

Medición correcta.

Medición correcta.

Medición correcta.

Medición correcta.

Medición correcta.

Medición correcta.

Medición correcta.

Medición correcta.

Medición correcta.

Medición correcta.

Falló la medición, marcó 0ppm

Falló la medición, marcó 0ppm

Falló la medición, marcó 0ppm

Medición correcta.

21.20 h 03.20 h 09.20 15.20 21.20

Medición correcta.

Medición correcta.

Medición correcta.

Medición correcta.

Medición correcta.

Medición correcta.

Medición correcta.

Medición correcta.

Medición correcta.

Medición correcta.

Medición correcta.

Medición correcta.

## Slide 10

Día 36 Día 37 Día 38 Día 39

28/04

00 hs

29/04

00 hs

30/04

00 hs

01/05

00 hs

18 06 12 18 06 12 18 06 12 18 06 12

23.20 h 01 07 13 19 01 07 13 19 01 07 13

(33) (34) (34) (34) (34) (34) (34) (34) (34) (34) (34) (34)

04 h 10 16 h 22 04 10 16 22 04 10 16

(33) (34) (34) (34) (34) (34) (34) (34) (34) (34) (34) (34)

Falló la medición, marcó 0ppm

Medición correcta.

Falló la medición, marcó 0ppm

Medición correcta.

Falló la medición, marcó 0ppm

Falló la medición, marcó 0ppm

Medición correcta.

Medición correcta.

Medición correcta.

Medición correcta.

Medición correcta.

Medición correcta.

Medición correcta.

Medición correcta.

Medición correcta.

Medición correcta.

Medición correcta.

02.20 h

Medición correcta.

Medición correcta.

Medición correcta.

Medición correcta.

Medición correcta.

Medición correcta.

Medición correcta.

Medición correcta.

Medición correcta.

Medición correcta.

Medición correcta.

## Slide 11

Día 40 Día 41

02/05

00 hs

03/05

00 hs

18 06 12 18 06 12 18 06 12 18 06 12

00 h 06 12 18 00

(35) (35) (35) (35) (35)

(35) (35) (35) (35)

Falló la medición, marcó 0ppm

Medición correcta.

Medición correcta.

Medición correcta.

Medición correcta.

Medición correcta.

Medición correcta.

Medición correcta.

03 h 09 15 21

Medición correcta.

Medición correcta.

Medición correcta.

Medición correcta.

Medición correcta.

Medición correcta.
