fyulita/laboratorio-6-y-7/Arduino/measurements/full-x4/2022-03-21_13-56-24/data_0.csv

Date_Time | CO2 | Estado_Valvula_1 | Estado_Valvula_2 | Estado_Valvula_3 | Estado_Valvula_4 | Temp_Compost_1 | Temp_Compost_2 | Temp_Compost_3 | Temp_Compost_4 | Temp_Suncho | Estado_Suncho
21/03/2022_13:56:27 | 756 | Prendido | Apagado | Apagado | Apagado | 25.69 | 25.37 | 25.06 | 24.56 | 25.25 | Prendido
21/03/2022_13:56:33 | 756 | Prendido | Apagado | Apagado | Apagado | 25.69 | 25.37 | 25.06 | 24.69 | 25.25 | Prendido
21/03/2022_13:56:39 | 755 | Prendido | Apagado | Apagado | Apagado | 25.69 | 25.37 | 25.06 | 24.56 | 25.25 | Prendido
21/03/2022_13:56:45 | 757 | Prendido | Apagado | Apagado | Apagado | 25.69 | 25.37 | 25.06 | 24.69 | 25.25 | Prendido
21/03/2022_13:56:50 | 758 | Prendido | Apagado | Apagado | Apagado | 25.69 | 25.37 | 25.06 | 24.62 | 25.25 | Prendido
21/03/2022_13:56:56 | 759 | Prendido | Apagado | Apagado | Apagado | 25.69 | 25.37 | 25.06 | 24.62 | 25.25 | Prendido
21/03/2022_13:57:02 | 759 | Prendido | Apagado | Apagado | Apagado | 25.69 | 25.37 | 25.06 | 24.69 | 25.25 | Prendido
21/03/2022_13:57:08 | 758 | Apagado | Prendido | Apagado | Apagado | 25.69 | 25.37 | 25.06 | 24.62 | 25.25 | Prendido
21/03/2022_13:57:14 | 758 | Apagado | Prendido | Apagado | Apagado | 25.62 | 25.37 | 25.12 | 24.69 | 25.25 | Prendido
21/03/2022_13:57:20 | 758 | Apagado | Prendido | Apagado | Apagado | 25.62 | 25.37 | 25.06 | 24.62 | 25.25 | Prendido
21/03/2022_13:57:26 | 758 | Apagado | Prendido | Apagado | Apagado | 25.69 | 25.37 | 25.06 | 24.75 | 25.25 | Prendido
21/03/2022_13:57:31 | 758 | Apagado | Prendido | Apagado | Apagado | 25.69 | 25.37 | 25.12 | 24.62 | 25.25 | Prendido
21/03/2022_13:57:37 | 760 | Apagado | Prendido | Apagado | Apagado | 25.75 | 25.37 | 25.12 | 24.62 | 25.25 | Prendido
21/03/2022_13:57:43 | 760 | Apagado | Apagado | Prendido | Apagado | 25.69 | 25.37 | 25.12 | 24.69 | 25.25 | Prendido
21/03/2022_13:57:49 | 762 | Apagado | Apagado | Prendido | Apagado | 25.69 | 25.37 | 25.12 | 24.75 | 25.25 | Prendido
21/03/2022_13:57:55 | 762 | Apagado | Apagado | Prendido | Apagado | 25.75 | 25.37 | 25.12 | 24.69 | 25.25 | Prendido
21/03/2022_13:58:01 | 762 | Apagado | Apagado | Prendido | Apagado | 25.69 | 25.37 | 25.19 | 24.69 | 25.25 | Prendido
21/03/2022_13:58:07 | 761 | Apagado | Apagado | Prendido | Apagado | 25.69 | 25.37 | 25.19 | 24.56 | 25.25 | Prendido
21/03/2022_13:58:12 | 761 | Apagado | Apagado | Prendido | Apagado | 25.69 | 25.37 | 25.12 | 24.75 | 25.25 | Prendido
21/03/2022_13:58:18 | 761 | Apagado | Apagado | Apagado | Prendido | 25.75 | 25.37 | 25.19 | 24.69 | 25.25 | Prendido
21/03/2022_13:58:24 | 761 | Apagado | Apagado | Apagado | Prendido | 25.69 | 25.37 | 25.19 | 24.56 | 25.25 | Prendido
21/03/2022_13:58:30 | 762 | Apagado | Apagado | Apagado | Prendido | 25.75 | 25.37 | 25.19 | 24.56 | 25.25 | Prendido
21/03/2022_13:58:36 | 763 | Apagado | Apagado | Apagado | Prendido | 25.69 | 25.37 | 25.12 | 24.69 | 25.25 | Prendido
21/03/2022_13:58:42 | 764 | Apagado | Apagado | Apagado | Prendido | 25.69 | 25.37 | 25.19 | 24.75 | 25.25 | Prendido
21/03/2022_13:58:48 | 765 | Apagado | Apagado | Apagado | Prendido | 25.69 | 25.37 | 25.12 | 24.69 | 25.25 | Prendido
21/03/2022_13:58:53 | 765 | Prendido | Apagado | Apagado | Apagado | 25.69 | 25.31 | 25.12 | 24.69 | 25.25 | Prendido
21/03/2022_13:58:59 | 765 | Prendido | Apagado | Apagado | Apagado | 25.69 | 25.37 | 25.12 | 24.69 | 25.25 | Prendido
21/03/2022_13:59:05 | 764 | Prendido | Apagado | Apagado | Apagado | 25.69 | 25.37 | 25.12 | 24.62 | 25.25 | Prendido
21/03/2022_13:59:11 | 765 | Prendido | Apagado | Apagado | Apagado | 25.69 | 25.37 | 25.19 | 24.69 | 25.25 | Prendido
21/03/2022_13:59:17 | 765 | Prendido | Apagado | Apagado | Apagado | 25.69 | 25.37 | 25.12 | 24.62 | 25.25 | Prendido
21/03/2022_13:59:23 | 765 | Prendido | Apagado | Apagado | Apagado | 25.69 | 25.37 | 25.12 | 24.69 | 25.25 | Prendido
21/03/2022_13:59:28 | 767 | Apagado | Prendido | Apagado | Apagado | 25.69 | 25.37 | 25.12 | 24.69 | 25.25 | Prendido
21/03/2022_13:59:34 | 769 | Apagado | Prendido | Apagado | Apagado | 25.69 | 25.37 | 25.12 | 24.56 | 25.25 | Prendido
21/03/2022_13:59:40 | 770 | Apagado | Prendido | Apagado | Apagado | 25.69 | 25.37 | 25.19 | 24.62 | 25.25 | Prendido
21/03/2022_13:59:46 | 770 | Apagado | Prendido | Apagado | Apagado | 25.69 | 25.37 | 25.19 | 24.75 | 25.25 | Prendido
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
21/03/2022_14:05:49 | 792 | Apagado | Apagado | Apagado | Prendido | 25.75 | 25.37 | 25.25 | 24.69 | 25.25 | Prendido
21/03/2022_14:05:55 | 791 | Prendido | Apagado | Apagado | Apagado | 25.75 | 25.37 | 25.19 | 24.69 | 25.25 | Prendido
21/03/2022_14:06:01 | 790 | Prendido | Apagado | Apagado | Apagado | 25.75 | 25.44 | 25.19 | 24.81 | 25.25 | Prendido
21/03/2022_14:06:07 | 787 | Prendido | Apagado | Apagado | Apagado | 25.75 | 25.37 | 25.19 | 24.81 | 25.25 | Prendido
