fyulita/laboratorio-6-y-7/Arduino/measurements/full-x4/2022-03-21_13-56-24/data_1.csv

Date_Time | CO2 | Estado_Valvula_1 | Estado_Valvula_2 | Estado_Valvula_3 | Estado_Valvula_4 | Temp_Compost_1 | Temp_Compost_2 | Temp_Compost_3 | Temp_Compost_4 | Temp_Suncho | Estado_Suncho
21/03/2022_14:06:13 | 786 | Prendido | Apagado | Apagado | Apagado | 25.69 | 25.37 | 25.19 | 24.75 | 25.25 | Prendido
