fyulita/laboratorio-6-y-7/Arduino/measurements/full-x4/2022-03-22_19-21-49/data_0.csv

Date_Time | CO2 | Estado_Valvula_1 | Estado_Valvula_2 | Estado_Valvula_3 | Estado_Valvula_4 | Temp_Compost_1 | Temp_Compost_2 | Temp_Compost_3 | Temp_Compost_4 | Temp_Suncho | Estado_Suncho
22/03/2022_19:21:49 | \x
22/03/2022_19:21:52 | 2854 | Apagado | Prendido | Apagado | Prendido | Apagado | Prendido | Apagado | Prendido | 43.25 | 48.44 | 50.44 | 42.31 | 49.63 | Prendido
22/03/2022_19:21:58 | 3172 | Apagado | Prendido | Apagado | Prendido | Apagado | Prendido | Apagado | Prendido | 43.25 | 48.44 | 50.38 | 42.31 | 49.56 | Prendido
