fyulita/laboratorio-6-y-7/Arduino/measurements/full-x4/2022-03-22_19-23-23/data_0.csv

Date_Time | CO2 | Estado_Valvula_1 | Estado_Valvula_2 | Estado_Valvula_3 | Estado_Valvula_4 | Temp_Compost_1 | Temp_Compost_2 | Temp_Compost_3 | Temp_Compost_4 | Temp_Suncho | Estado_Suncho
22/03/2022_19:23:23 | \x
22/03/2022_19:23:26 | 4421 | Apagado | Prendido | Apagado | Prendido | Apagado | Prendido | Apagado | Prendido | 43.00 | 48.19 | 50.00 | 44.38 | 49.25 | Prendido
22/03/2022_19:23:32 | 4427 | Apagado | Prendido | Apagado | Prendido | Apagado | Prendido | Apagado | Prendido | 43.00 | 48.19 | 50.00 | 44.38 | 49.25 | Prendido
