fyulita/laboratorio-6-y-7/Arduino/measurements/full-x4/2022-04-28_23-58-04/figuras/promedio.csv

# nro | promedio1 | promedio2 | promedio3 | promedio4
1.000000000000000000e+00 | 5.764453441295546554e+02 | 5.496639676113360338e+02 | 6.478542510121457099e+02 | 6.120647773279351895e+02
2.000000000000000000e+00 | 5.389919028340081013e+02 | 5.155020242914979463e+02 | 6.083157894736841627e+02 | 6.019433198380567092e+02
3.000000000000000000e+00 | 5.739311740890688043e+02 | 2.077105263157894569e+03 | 6.174048582995951620e+02 | 6.172874493927125741e+02
4.000000000000000000e+00 | 5.068542510121457667e+02 | 5.029959514170040507e+02 | 5.547975708502024190e+02 | 5.796518218623481289e+02
5.000000000000000000e+00 | 5.259676113360324052e+02 | 5.103024193548387188e+02 | 5.250526315789473983e+02 | 5.947349397590361377e+02
6.000000000000000000e+00 | 5.383333333333333712e+02 | 5.361680000000000064e+02 | 6.018588709677419502e+02 | 5.967338709677419502e+02
7.000000000000000000e+00 | 6.076720647773279325e+02 | 6.000850202429149931e+02 | 6.966518218623481289e+02 | 7.569797570850201964e+02
8.000000000000000000e+00 | 7.091740890688258787e+02 | 1.153914979757085121e+03 | 8.533562753036437698e+02 | 7.541295546558704928e+02
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
