fyulita/laboratorio-6-y-7/Arduino/measurements/full-x4/2022-04-28_23-58-04/figuras/promedio_std.csv

# nro | promedio_std1 | promedio_std2 | promedio_std3 | promedio_std4
1.000000000000000000e+00 | 1.415143833918692806e+01 | 9.205065783573884275e+00 | 1.365935384694094168e+01 | 6.734094639848281716e+00
2.000000000000000000e+00 | 1.957669272371244773e+01 | 6.543454555636276204e+00 | 9.183987213507265324e+00 | 3.803475119778285674e+00
3.000000000000000000e+00 | 1.303930991559584562e+01 | 1.831133944730889027e+02 | 8.941445637095579713e+00 | 9.994450098212382727e+00
4.000000000000000000e+00 | 2.080337416540253770e+01 | 6.443461975712861722e+00 | 1.659836079689092969e+01 | 4.095053142948284375e+00
5.000000000000000000e+00 | 1.477629967028641111e+01 | 1.092834405681581345e+01 | 2.821220310443631973e+01 | 1.034864250533365038e+01
6.000000000000000000e+00 | 1.147466798451059233e+01 | 9.210633854409802979e+00 | 1.405290414307016000e+01 | 8.556368002996686428e+00
7.000000000000000000e+00 | 5.308475099540694409e+00 | 8.721794232565784455e+00 | 2.010519467590705389e+01 | 3.287252392334348627e+01
8.000000000000000000e+00 | 3.223229917334728611e+01 | 8.197163562392749725e+01 | 1.219421907459381593e+01 | 5.220389232122332146e+01
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
