fyulita/laboratorio-6-y-7/Arduino/measurements/full-x4/2022-04-15_09-52-33/figuras/promedio.csv

# nro | promedio1 | promedio2 | promedio3 | promedio4
1.000000000000000000e+00 | 4.623360323886639662e+02 | 4.808016194331983684e+02 | 6.829068825910931082e+02 | 6.736437246963562302e+02
2.000000000000000000e+00 | 5.478947368421053170e+02 | 4.636356275303643883e+02 | 5.728744939271255134e+02 | 5.579838056680162026e+02
3.000000000000000000e+00 | 4.816315789473684390e+02 | 5.877489878542510269e+02 | 7.617044534412955272e+02 | 6.876396761133603377e+02
4.000000000000000000e+00 | 5.275425101214574397e+02 | 6.915708502024291420e+02 | 1.085502024291497946e+03 | 9.539757085020243039e+02
5.000000000000000000e+00 | 6.122591093117408718e+02 | 6.910242914979756961e+02 | 1.007631578947368439e+03 | 7.179554655870445004e+02
6.000000000000000000e+00 | 5.079352226720647536e+02 | 5.817287449392712233e+02 | 8.211700404858299862e+02 | 6.562348178137651757e+02
7.000000000000000000e+00 | 4.966518218623481857e+02 | 5.519959514170039938e+02 | 7.833157894736841627e+02 | 6.181902834008096761e+02
8.000000000000000000e+00 | 4.630526315789473415e+02 | 5.405546558704453446e+02 | 7.465384615384615472e+02 | 6.363481781376518711e+02
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
