fyulita/laboratorio-6-y-7/Arduino/measurements/full-x4/2022-04-15_09-52-33/figuras/promedio_std.csv

# nro | promedio_std1 | promedio_std2 | promedio_std3 | promedio_std4
1.000000000000000000e+00 | 1.116187650406813781e+01 | 3.853413647002870590e+01 | 1.015444664361564442e+01 | 4.486410645120549390e+01
2.000000000000000000e+00 | 3.690107484242010116e+01 | 1.220824810413834705e+01 | 8.875912295413584729e+00 | 1.276031538304542501e+01
3.000000000000000000e+00 | 1.633275857808726528e+01 | 1.049048870294292435e+01 | 4.496275674752273233e+01 | 3.045664145637171316e+01
4.000000000000000000e+00 | 2.730138461317404008e+01 | 2.832292887550425320e+01 | 1.283075718414687287e+02 | 2.416105326643209494e+01
5.000000000000000000e+00 | 7.460800168209941319e+01 | 1.561633296479220157e+01 | 1.658342591010169187e+01 | 1.393950349104124342e+01
6.000000000000000000e+00 | 4.374643334335254430e+00 | 4.400416759307213432e+00 | 5.877583263434369876e+00 | 1.732429206092278307e+01
7.000000000000000000e+00 | 2.944875931455820606e+00 | 4.667484194958810839e+00 | 3.173376355577795849e+00 | 2.060679270502084393e+01
8.000000000000000000e+00 | 1.327539439390252696e+01 | 2.055987721746810948e+01 | 1.022844026944903639e+01 | 5.195568248060020977e+01
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
