fyulita/laboratorio-6-y-7/Arduino/measurements/full-x4/2022-04-22_08-23-06/figuras/promedio.csv

# nro | promedio1 | promedio2 | promedio3 | promedio4
1.000000000000000000e+00 | 4.165789473684210407e+02 | 6.228623481781376086e+02 | 4.975182186234818005e+02 | 5.184696356275303515e+02
2.000000000000000000e+00 | 4.088137651821862164e+02 | 5.750809716599189869e+02 | 5.575060728744939524e+02 | 4.836072874493926861e+02
3.000000000000000000e+00 | 4.022914979757085234e+02 | 5.391012145748987905e+02 | 4.520080971659918987e+02 | 4.486194331983805910e+02
4.000000000000000000e+00 | 5.260566801619432908e+02 | 6.191700404858299862e+02 | 4.690850202429149931e+02 | 4.774817813765181995e+02
5.000000000000000000e+00 | 6.647368421052631220e+02 | 8.026356275303643315e+02 | 7.203238866396760613e+02 | 6.317085020242915334e+02
6.000000000000000000e+00 | 4.560647773279352464e+02 | 6.181174089068825879e+02 | 5.466963562753036285e+02 | 5.182834008097165679e+02
7.000000000000000000e+00 | 4.325465587044534459e+02 | 5.582267206477732771e+02 | 5.064534412955465541e+02 | 4.887327935222672295e+02
8.000000000000000000e+00 | 4.415546558704453446e+02 | 4.949716599190283546e+02 | 5.333765182186234597e+02 | 5.268623481781376086e+02
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
