fyulita/laboratorio-6-y-7/Arduino/measurements/full-x4/2022-04-22_08-23-06/figuras/promedio_std.csv

# nro | promedio_std1 | promedio_std2 | promedio_std3 | promedio_std4
1.000000000000000000e+00 | 8.051004042878410871e+00 | 9.942205426215632968e+00 | 1.796889665586417806e+01 | 9.282677757251164508e+00
2.000000000000000000e+00 | 3.991607186167780430e+00 | 2.100822863334597557e+01 | 1.218011602071548793e+01 | 1.382699742620412309e+01
3.000000000000000000e+00 | 4.995144259890938798e+00 | 4.291253525999478846e+00 | 1.456105167678071943e+01 | 9.142202429709181288e+00
4.000000000000000000e+00 | 1.594210254367623492e+01 | 1.233947260659414091e+01 | 7.077710514933021280e+00 | 3.230382512140738527e+01
5.000000000000000000e+00 | 2.697276289529565929e+01 | 1.701906605021527952e+01 | 1.312538244190464454e+01 | 1.810126845329953227e+01
6.000000000000000000e+00 | 1.199003695090304511e+01 | 7.573551662477266966e+00 | 1.034471186869635595e+01 | 8.364703639520254086e+00
7.000000000000000000e+00 | 9.579671157900845557e+00 | 2.913950560550187863e+00 | 5.843857141917209397e+00 | 4.972134648766473930e+00
8.000000000000000000e+00 | 2.732315327782498215e+01 | 1.013168390259776608e+01 | 6.265380687926937142e+00 | 4.797654554352734024e+00
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
