fyulita/laboratorio-6-y-7/Arduino/measurements/full-x4/2022-04-03_12-28-33/figuras/promedio.csv

# nro | promedio1 | promedio2 | promedio3 | promedio4
1.000000000000000000e+00 | 4.725910931174088887e+02 | 7.063400809716599724e+02 | 7.981659919028339800e+02 | 0.000000000000000000e+00
