fyulita/laboratorio-6-y-7/Arduino/measurements/CO2/2021-09-20_16-07-59/figuras/CO2.png

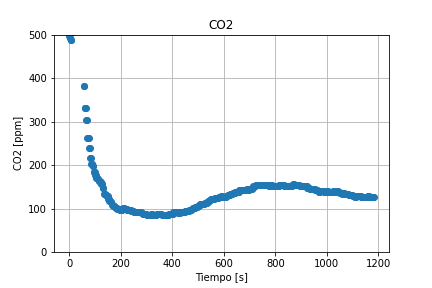
Arduino/measurements/CO2/2021-09-20_16-07-59/figuras/CO2.png
