fyulita/laboratorio-6-y-7/Arduino/measurements/CO2/2021-09-22_10-20-58/figuras/CO2.png

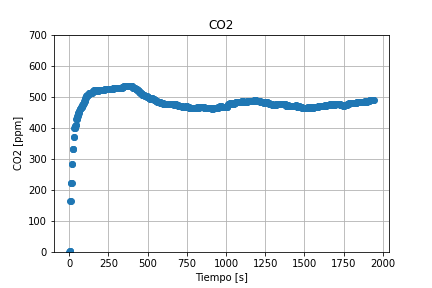
Arduino/measurements/CO2/2021-09-22_10-20-58/figuras/CO2.png
