fyulita/laboratorio-6-y-7/Arduino/measurements/CO2/2021-10-13_16-23-39/figuras/CO2.png

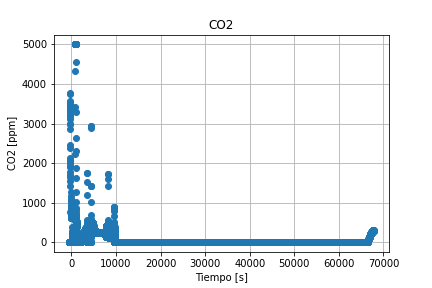
Arduino/measurements/CO2/2021-10-13_16-23-39/figuras/CO2.png
