fyulita/laboratorio-6-y-7/Arduino/measurements/CO2/cal-sodada_200g/CO2.png

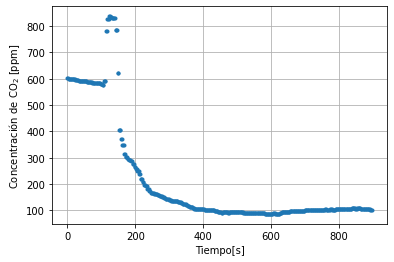
Arduino/measurements/CO2/cal-sodada_200g/CO2.png
