fyulita/laboratorio-6-y-7/Arduino/measurements/CO2/cal-sodada_300g/CO2.png

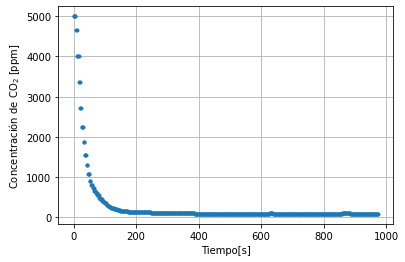
Arduino/measurements/CO2/cal-sodada_300g/CO2.png
