fyulita/laboratorio-6-y-7/Arduino/measurements/full-x4/2021-10-19_20-09-18/figuras/CO2_marcado.png

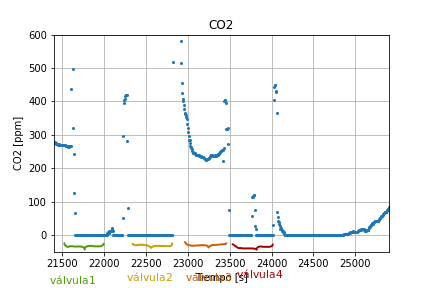
Arduino/measurements/full-x4/2021-10-19_20-09-18/figuras/CO2_marcado.png
