fyulita/laboratorio-6-y-7/Arduino/measurements/full-x4/2021-10-27_00-19-57/figuras/CO2.png

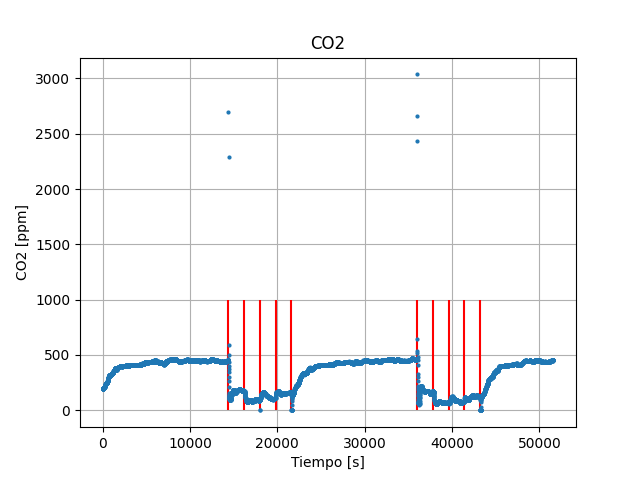
Arduino/measurements/full-x4/2021-10-27_00-19-57/figuras/CO2.png
