fyulita/laboratorio-6-y-7/Arduino/measurements/full-x4/2021-11-03_17-49-11/figuras/medicion_6.png

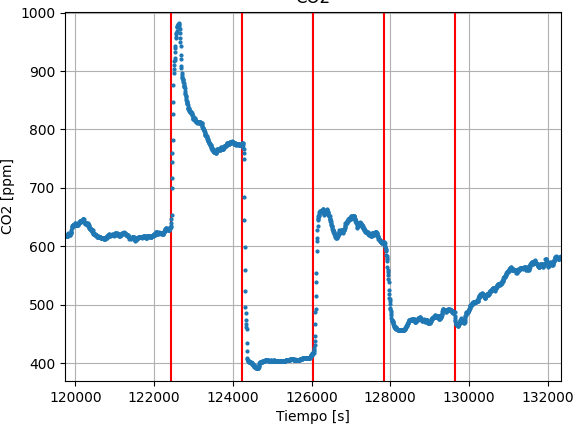
Arduino/measurements/full-x4/2021-11-03_17-49-11/figuras/medicion_6.png
