fyulita/laboratorio-6-y-7/Arduino/measurements/full-x4/2021-11-05_18-09-50/figuras/Temperatura.png

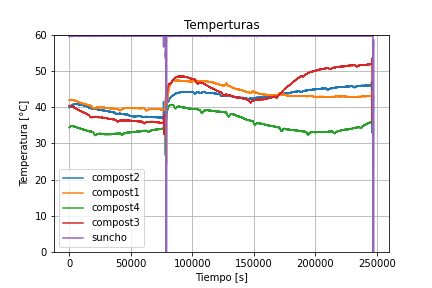
Arduino/measurements/full-x4/2021-11-05_18-09-50/figuras/Temperatura.png
