fyulita/laboratorio-6-y-7/Arduino/measurements/full-x4/2021-11-08_15-57-42/figuras/Temperatura.png

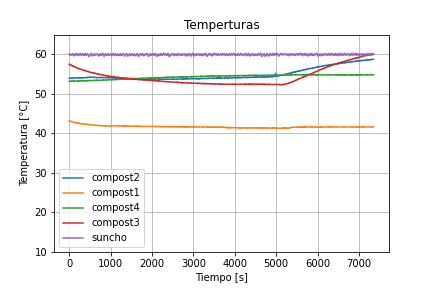
Arduino/measurements/full-x4/2021-11-08_15-57-42/figuras/Temperatura.png
