fyulita/laboratorio-6-y-7/Arduino/measurements/full-x4/2021-11-08_18-00-42/figuras/Temperatura.png

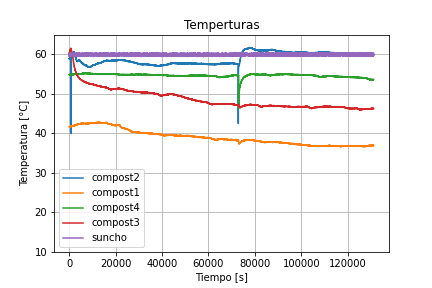
Arduino/measurements/full-x4/2021-11-08_18-00-42/figuras/Temperatura.png
