fyulita/laboratorio-6-y-7/Arduino/measurements/full-x4/2021-11-17_19-34-49/figuras/CO2.png

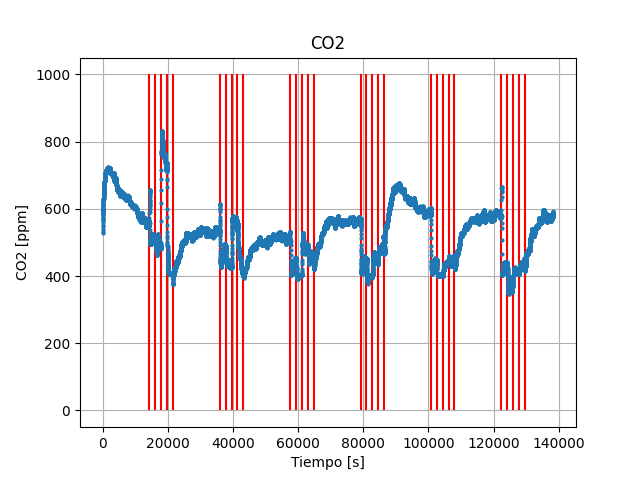
Arduino/measurements/full-x4/2021-11-17_19-34-49/figuras/CO2.png
