fyulita/laboratorio-6-y-7/Arduino/measurements/full-x4/2021-11-27_16-16-53/figuras/CO2_completo.png

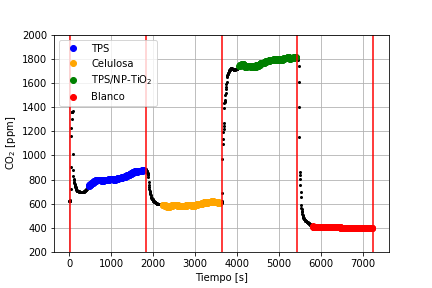
Arduino/measurements/full-x4/2021-11-27_16-16-53/figuras/CO2_completo.png
