fyulita/laboratorio-6-y-7/Arduino/measurements/full-x4/2021-11-27_16-16-53/figuras/co2_con_error3.png

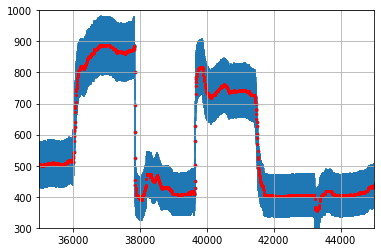
Arduino/measurements/full-x4/2021-11-27_16-16-53/figuras/co2_con_error3.png
