fyulita/laboratorio-6-y-7/Arduino/measurements/full-x4/2021-11-27_18-22-19-EDITADO/PRUEBA_1135-1163/figuras/Temperatura.png

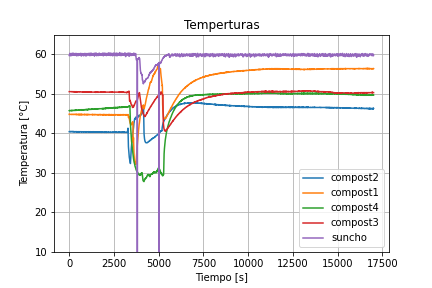
Arduino/measurements/full-x4/2021-11-27_18-22-19-EDITADO/PRUEBA_1135-1163/figuras/Temperatura.png
