fyulita/laboratorio-6-y-7/Arduino/measurements/full-x4/2022-03-22_19-59-55/figuras/Temperatura.png

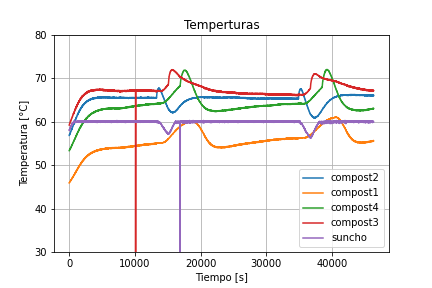
Arduino/measurements/full-x4/2022-03-22_19-59-55/figuras/Temperatura.png
