fyulita/laboratorio-6-y-7/Arduino/measurements/full-x4/2022-03-23_13-51-15/figuras/CO2_completo.png

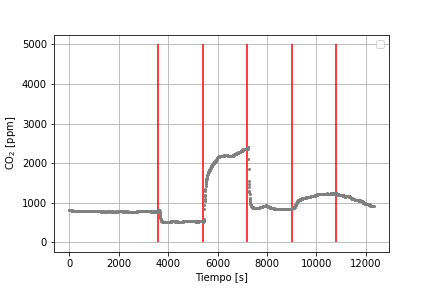
Arduino/measurements/full-x4/2022-03-23_13-51-15/figuras/CO2_completo.png
