fyulita/laboratorio-6-y-7/Arduino/measurements/full-x4/2022-03-24_00-51-44/figuras/CO2_4bis.png

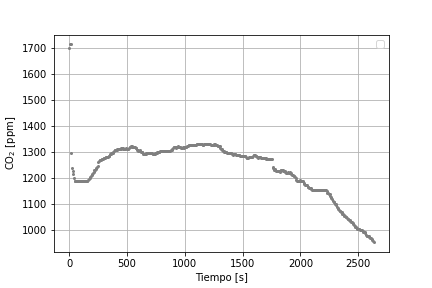
Arduino/measurements/full-x4/2022-03-24_00-51-44/figuras/CO2_4bis.png
