fyulita/laboratorio-6-y-7/Arduino/measurements/full-x4/2022-03-24_04-46-10/figuras/Temperatura.png

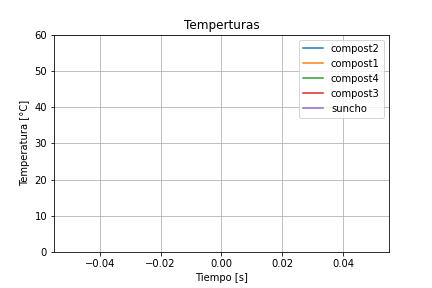
Arduino/measurements/full-x4/2022-03-24_04-46-10/figuras/Temperatura.png
