fyulita/laboratorio-6-y-7/Arduino/measurements/full-x4/2022-03-24_15-05-20/3-4/figuras/Temperatura.png

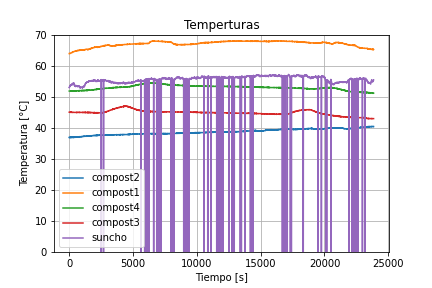
Arduino/measurements/full-x4/2022-03-24_15-05-20/3-4/figuras/Temperatura.png
