fyulita/laboratorio-6-y-7/Arduino/measurements/full-x4/2022-03-25_07-30-02/figuras/areas_pintadas.png

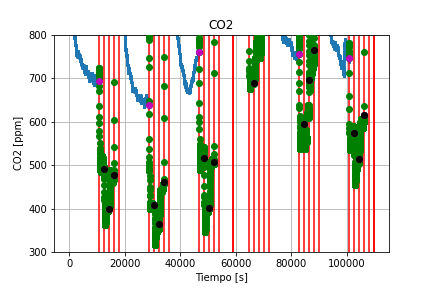
Arduino/measurements/full-x4/2022-03-25_07-30-02/figuras/areas_pintadas.png
