fyulita/laboratorio-6-y-7/Arduino/measurements/full-x4/2022-03-26_14-02-02/2-4/figuras/Temperatura.png

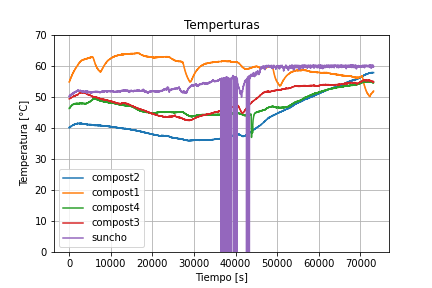
Arduino/measurements/full-x4/2022-03-26_14-02-02/2-4/figuras/Temperatura.png
