fyulita/laboratorio-6-y-7/Arduino/measurements/full-x4/2022-03-27_20-20-20/figuras/Temperatura.png

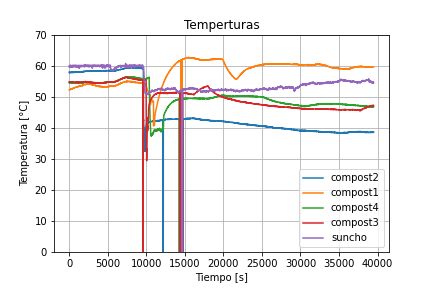
Arduino/measurements/full-x4/2022-03-27_20-20-20/figuras/Temperatura.png
