fyulita/laboratorio-6-y-7/Arduino/measurements/full-x4/2022-03-28_07-19-09/figuras/CO2_completo.png

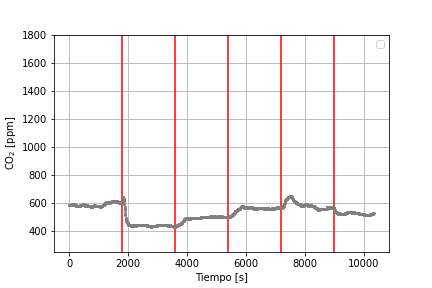
Arduino/measurements/full-x4/2022-03-28_07-19-09/figuras/CO2_completo.png
