fyulita/laboratorio-6-y-7/Arduino/measurements/full-x4/2022-03-28_10-12-37/figuras/areas_pintadas-HASTA9.png

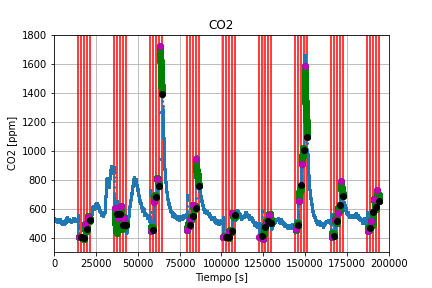
Arduino/measurements/full-x4/2022-03-28_10-12-37/figuras/areas_pintadas-HASTA9.png
