fyulita/laboratorio-6-y-7/Arduino/measurements/full-x4/2022-04-04_09-22-33/figuras/CO2_completo.png

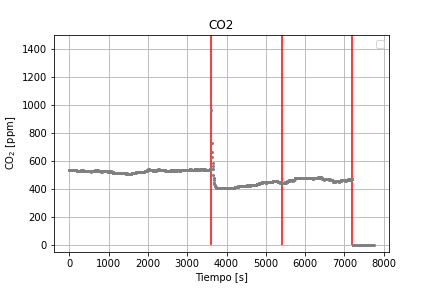
Arduino/measurements/full-x4/2022-04-04_09-22-33/figuras/CO2_completo.png
