fyulita/laboratorio-6-y-7/Arduino/measurements/full-x4/2022-04-04_11-31-54/figuras/Temperatura.png

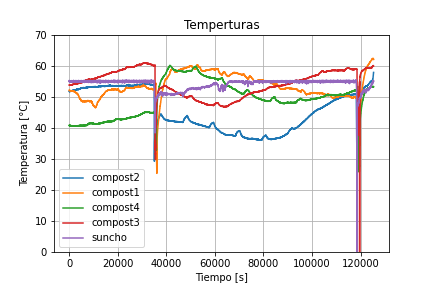
Arduino/measurements/full-x4/2022-04-04_11-31-54/figuras/Temperatura.png
