fyulita/laboratorio-6-y-7/Arduino/measurements/full-x4/2022-04-05_22-21-39/figuras/areas_pintadas-parte2.png

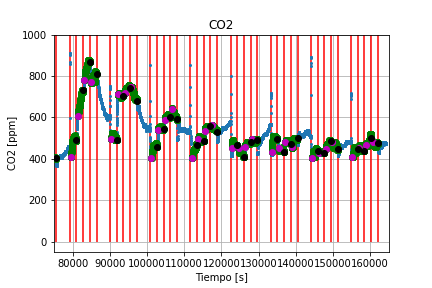
Arduino/measurements/full-x4/2022-04-05_22-21-39/figuras/areas_pintadas-parte2.png
