fyulita/laboratorio-6-y-7/Arduino/measurements/full-x4/2022-04-07_20-17-51/figuras/areas_pintadas.png

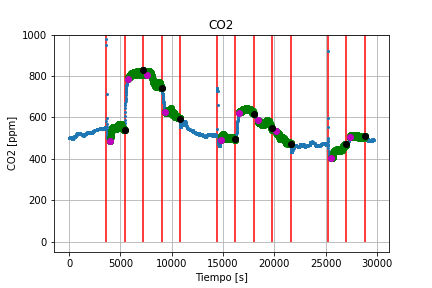
Arduino/measurements/full-x4/2022-04-07_20-17-51/figuras/areas_pintadas.png
