fyulita/laboratorio-6-y-7/Arduino/measurements/full-x4/2022-04-07_20-17-51/figuras/CO2_completo.png

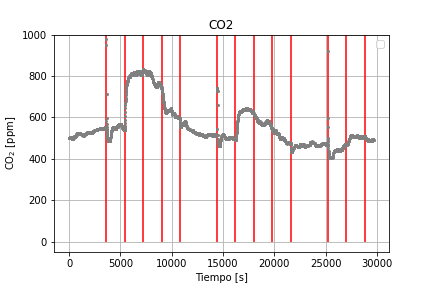
Arduino/measurements/full-x4/2022-04-07_20-17-51/figuras/CO2_completo.png
