fyulita/laboratorio-6-y-7/Arduino/measurements/full-x4/2022-04-08_10-23-42/figuras/areas_pintadas_parte1.png

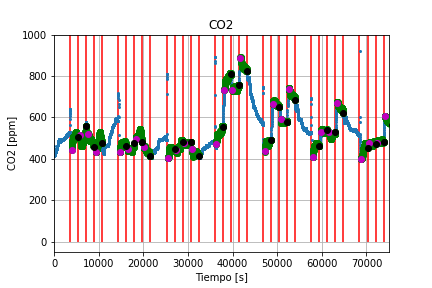
Arduino/measurements/full-x4/2022-04-08_10-23-42/figuras/areas_pintadas_parte1.png
