fyulita/laboratorio-6-y-7/Arduino/measurements/full-x4/2022-04-10_02-36-21/figuras/Temperatura.png

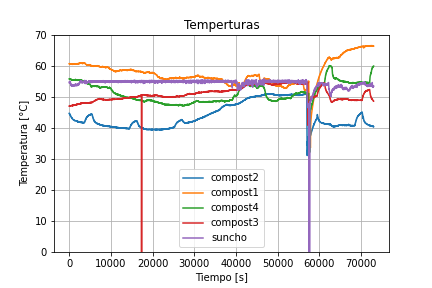
Arduino/measurements/full-x4/2022-04-10_02-36-21/figuras/Temperatura.png
