fyulita/laboratorio-6-y-7/Arduino/measurements/full-x4/2022-04-10_22-53-47/figuras/Temperatura.png

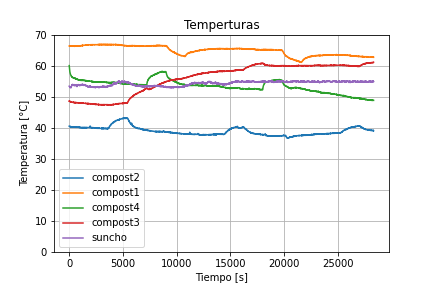
Arduino/measurements/full-x4/2022-04-10_22-53-47/figuras/Temperatura.png
