fyulita/laboratorio-6-y-7/Arduino/measurements/full-x4/2022-04-11_06-46-19/figuras/Temperatura.png

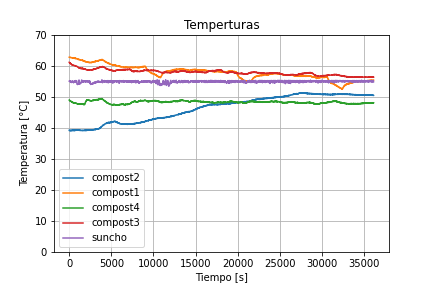
Arduino/measurements/full-x4/2022-04-11_06-46-19/figuras/Temperatura.png
