fyulita/laboratorio-6-y-7/Arduino/measurements/full-x4/2022-04-11_17-00-09/figuras/CO2_22.png

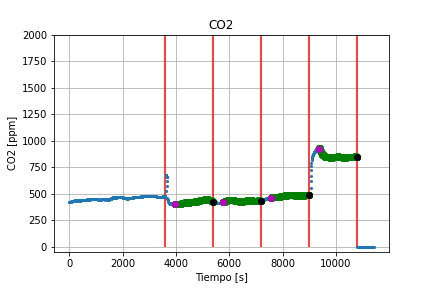
Arduino/measurements/full-x4/2022-04-11_17-00-09/figuras/CO2_22.png
