fyulita/laboratorio-6-y-7/Arduino/measurements/full-x4/2022-04-12_19-11-10/figuras/areas_pintadas.png

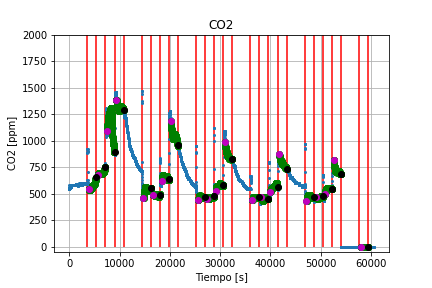
Arduino/measurements/full-x4/2022-04-12_19-11-10/figuras/areas_pintadas.png
