fyulita/laboratorio-6-y-7/Arduino/measurements/full-x4/2022-04-13_11-59-42/figuras/areas_pintadas.png

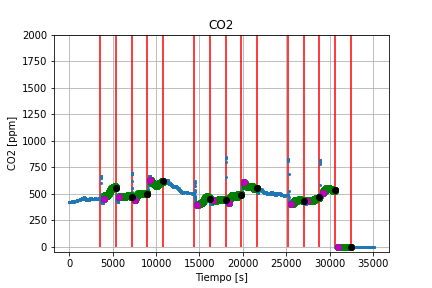
Arduino/measurements/full-x4/2022-04-13_11-59-42/figuras/areas_pintadas.png
