fyulita/laboratorio-6-y-7/Arduino/measurements/full-x4/2022-04-13_21-43-57/figuras/Temperatura.png

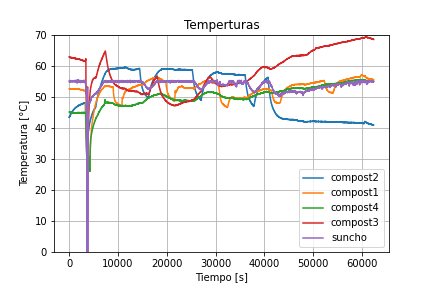
Arduino/measurements/full-x4/2022-04-13_21-43-57/figuras/Temperatura.png
