fyulita/laboratorio-6-y-7/Arduino/measurements/full-x4/2022-04-14_15-03-19/figuras/Temperatura.png

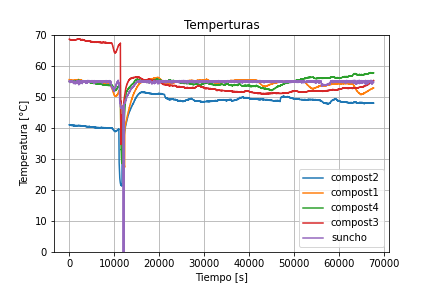
Arduino/measurements/full-x4/2022-04-14_15-03-19/figuras/Temperatura.png
