fyulita/laboratorio-6-y-7/Arduino/measurements/full-x4/2022-04-15_09-52-33/figuras/areas_pintadas-cortado.png

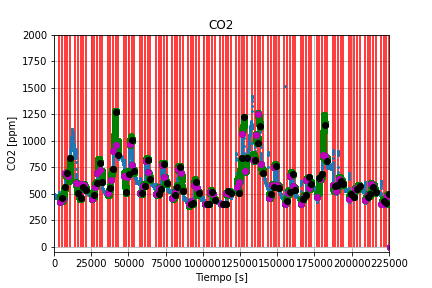
Arduino/measurements/full-x4/2022-04-15_09-52-33/figuras/areas_pintadas-cortado.png
