fyulita/laboratorio-6-y-7/Arduino/measurements/full-x4/2022-04-15_09-52-33/figuras/Temperatura.png

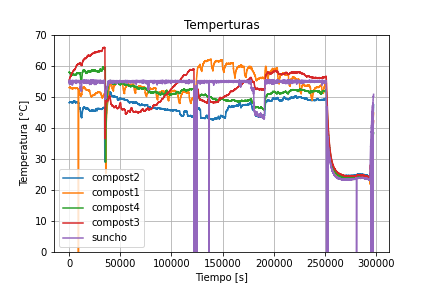
Arduino/measurements/full-x4/2022-04-15_09-52-33/figuras/Temperatura.png
