fyulita/laboratorio-6-y-7/Arduino/measurements/full-x4/2022-04-20_22-58-29/figuras/CO2_completo.png

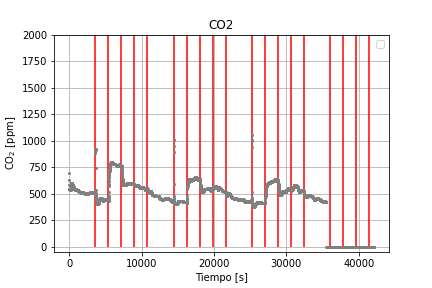
Arduino/measurements/full-x4/2022-04-20_22-58-29/figuras/CO2_completo.png
