fyulita/laboratorio-6-y-7/Arduino/measurements/full-x4/2022-04-20_22-58-29/figuras/Temperatura.png

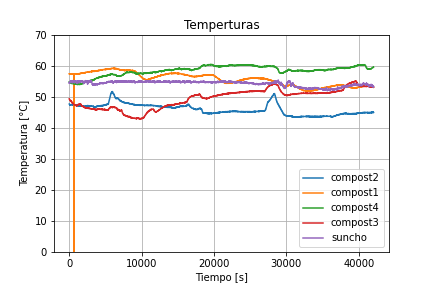
Arduino/measurements/full-x4/2022-04-20_22-58-29/figuras/Temperatura.png
