fyulita/laboratorio-6-y-7/Arduino/measurements/full-x4/2022-04-21_10-39-29/figuras/Temperatura.png

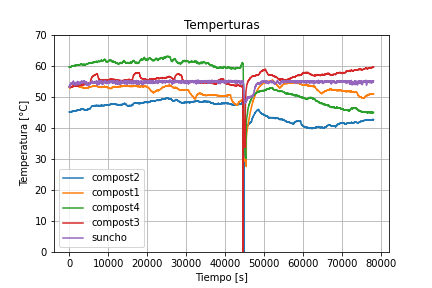
Arduino/measurements/full-x4/2022-04-21_10-39-29/figuras/Temperatura.png
