fyulita/laboratorio-6-y-7/Arduino/measurements/full-x4/2022-04-22_08-23-06/figuras/CO2_completo.png

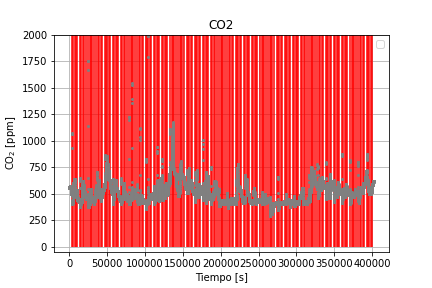
Arduino/measurements/full-x4/2022-04-22_08-23-06/figuras/CO2_completo.png
