fyulita/laboratorio-6-y-7/Arduino/measurements/full-x4/2022-04-27_22-19-45/figuras/Temperatura.png

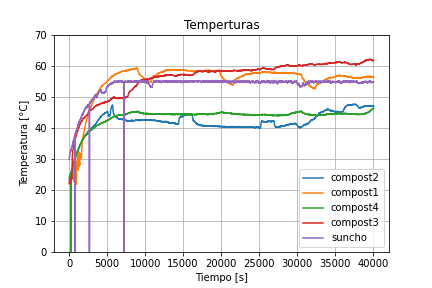
Arduino/measurements/full-x4/2022-04-27_22-19-45/figuras/Temperatura.png
