fyulita/laboratorio-6-y-7/Arduino/measurements/full-x4/2022-04-28_23-58-04/figuras/areas_pintadas-cortado1.png

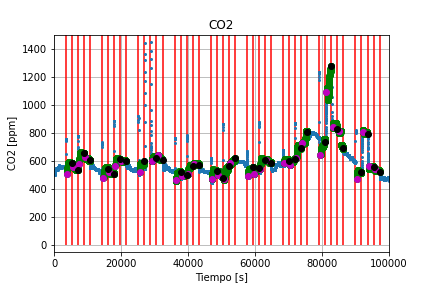
Arduino/measurements/full-x4/2022-04-28_23-58-04/figuras/areas_pintadas-cortado1.png
