fyulita/laboratorio-6-y-7/Arduino/measurements/full-x4/2022-05-01_23-06-08/figuras/Temperatura.png

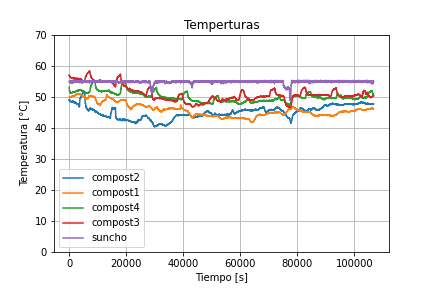
Arduino/measurements/full-x4/2022-05-01_23-06-08/figuras/Temperatura.png
