fyulita/laboratorio-6-y-7/Arduino/measurements/full-x4/resumen-5dias.png

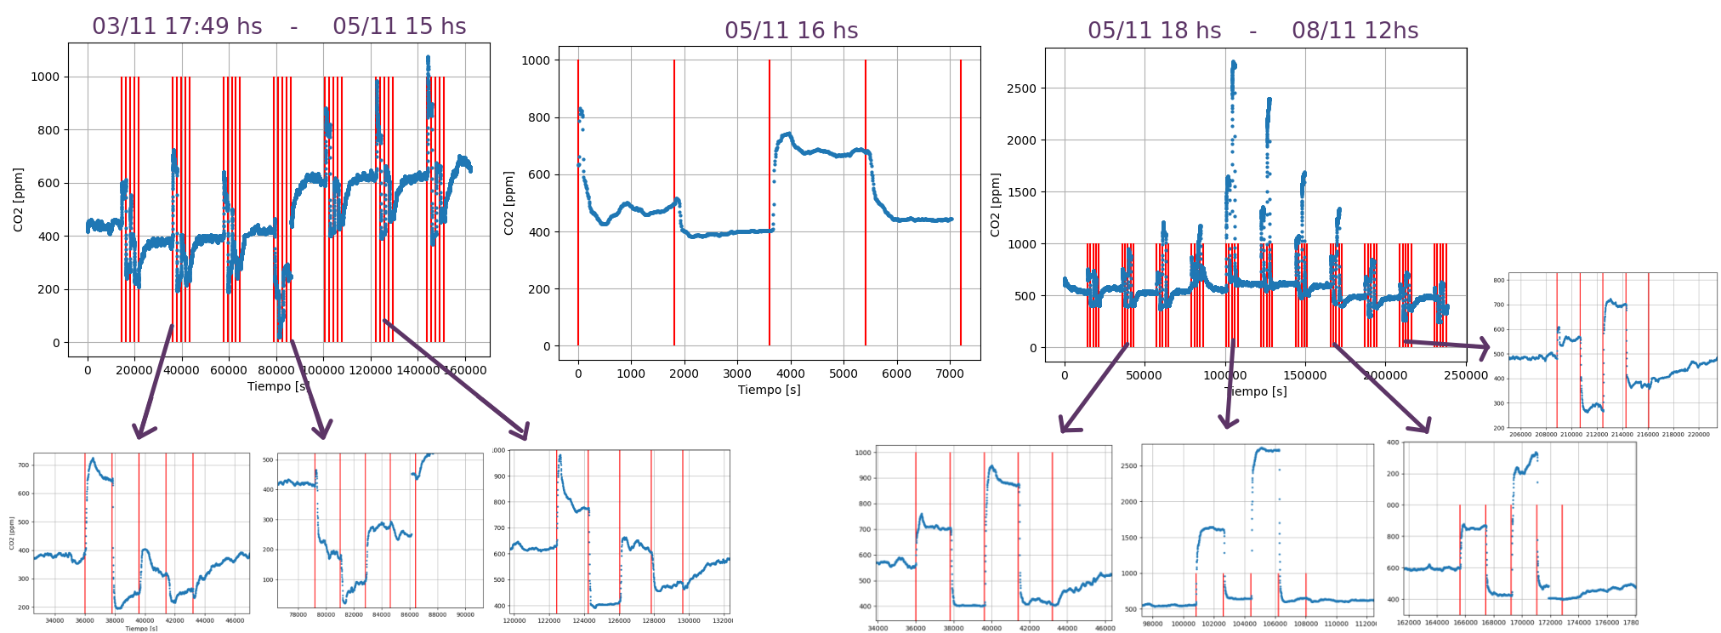
Arduino/measurements/full-x4/resumen-5dias.png
