fyulita/laboratorio-6-y-7/Arduino/measurements/full/2021-09-22_15-14-57/figuras/CO2.png

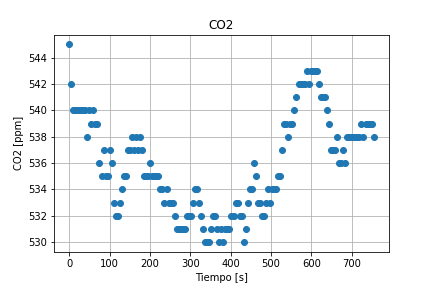
Arduino/measurements/full/2021-09-22_15-14-57/figuras/CO2.png
