fyulita/laboratorio-6-y-7/Arduino/measurements/full/2021-10-23_17-20-56/figuras/Temperatura-juntos.png

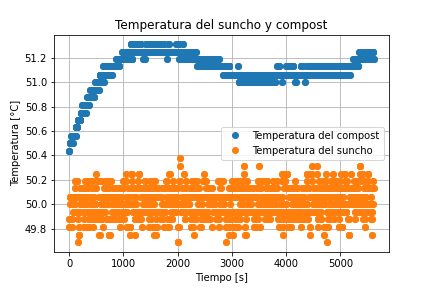
Arduino/measurements/full/2021-10-23_17-20-56/figuras/Temperatura-juntos.png
