fyulita/laboratorio-6-y-7/Arduino/measurements/full/2021-10-24_20-48-22/figuras/CO2.png

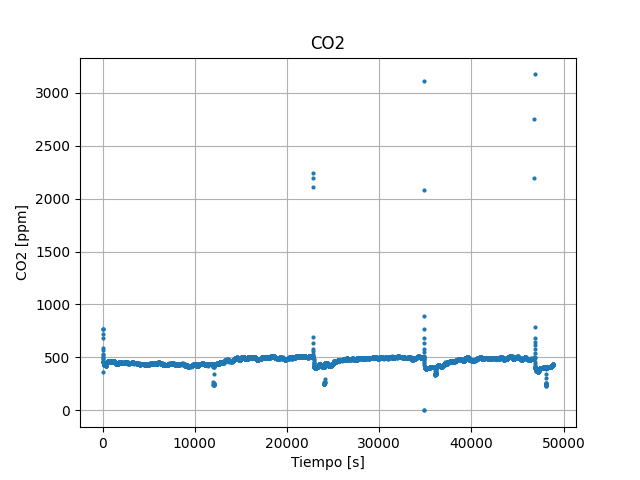
Arduino/measurements/full/2021-10-24_20-48-22/figuras/CO2.png
