fyulita/laboratorio-6-y-7/Arduino/measurements/temp/2021-06-14_18-12-22/figuras/Temperatura-juntos-edited.png

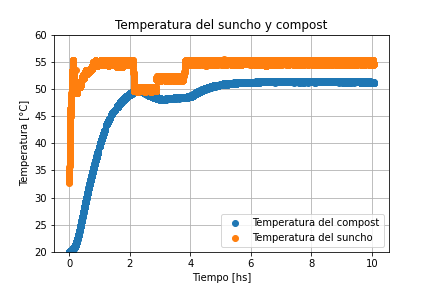
Arduino/measurements/temp/2021-06-14_18-12-22/figuras/Temperatura-juntos-edited.png
