fyulita/laboratorio-6-y-7/Arduino/measurements/temp/2021-06-29_18-12-46/figuras/Temperatura-del-Compost.png

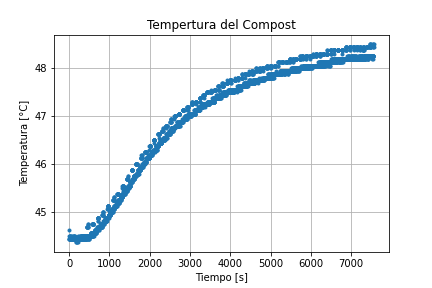
Arduino/measurements/temp/2021-06-29_18-12-46/figuras/Temperatura-del-Compost.png
