fyulita/laboratorio-6-y-7/Imagenes/prueba.png

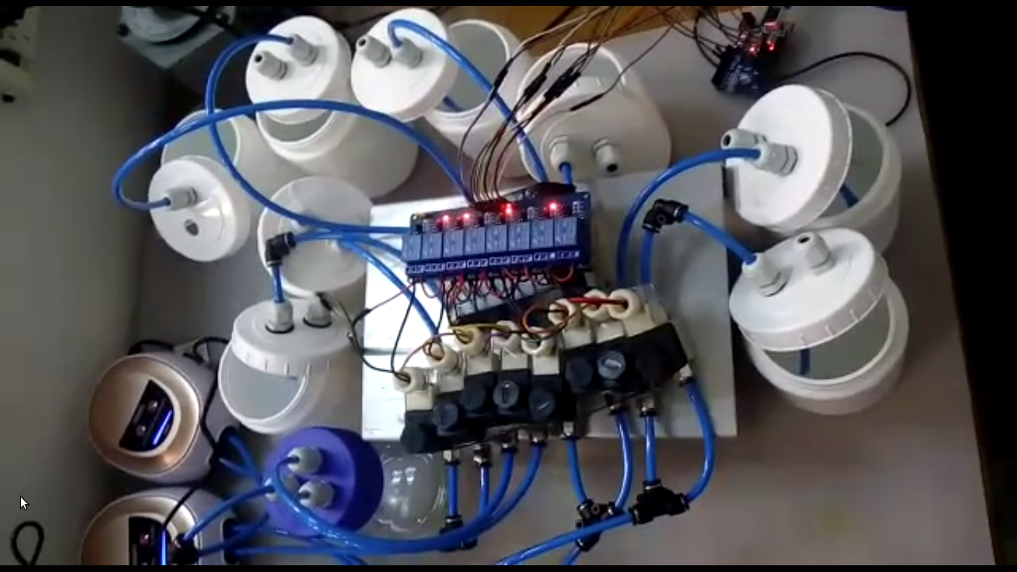
Imagenes/prueba.png
