fyulita/laboratorio-6-y-7/TEST3/CO2_2.png

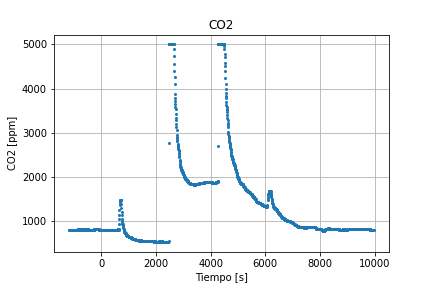
TEST3/CO2_2.png
