fyulita/laboratorio-6-y-7/TEST3/CO2_3.png

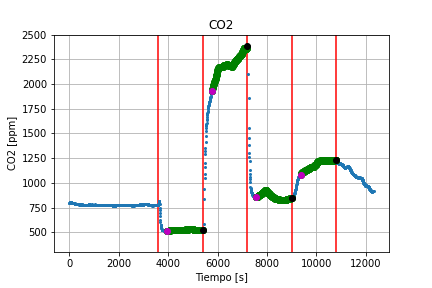
TEST3/CO2_3.png
