fyulita/laboratorio-6-y-7/TEST3/CO2_32-zoom.png

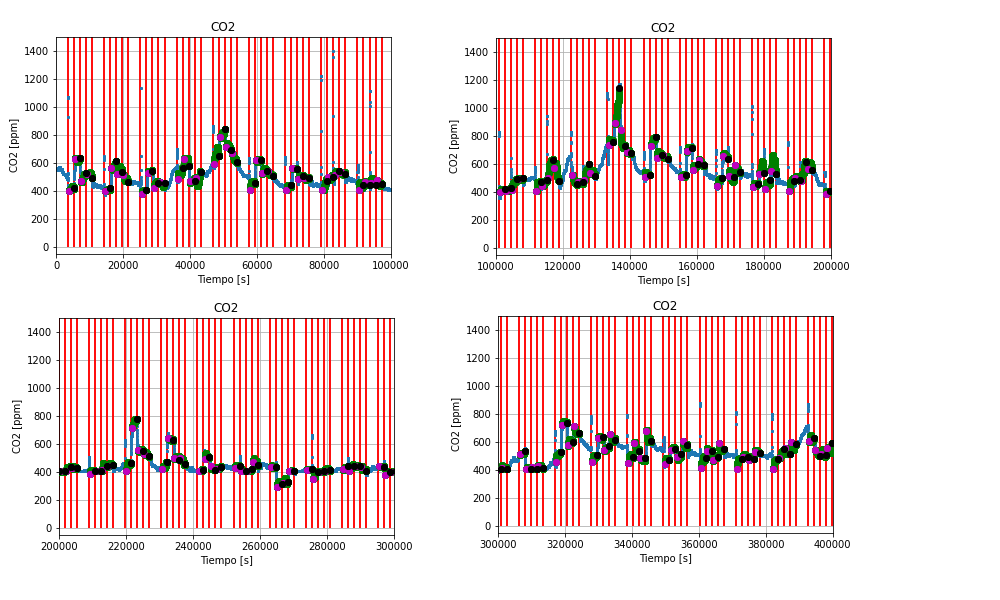
TEST3/CO2_32-zoom.png
