fyulita/laboratorio-6-y-7/TEST3/CO2_32.png

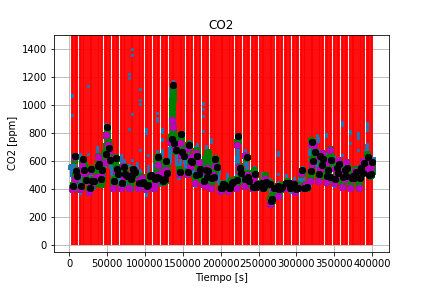
TEST3/CO2_32.png
