fyulita/laboratorio-6-y-7/TEST3/CO2_34-zoom.png

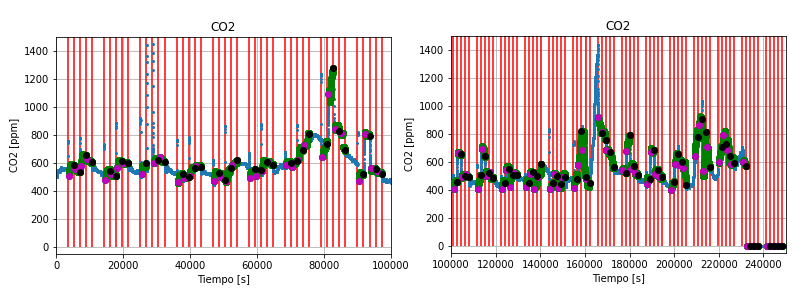
TEST3/CO2_34-zoom.png
