fyulita/laboratorio-6-y-7/TEST3/co2_acumulado-sensor.png

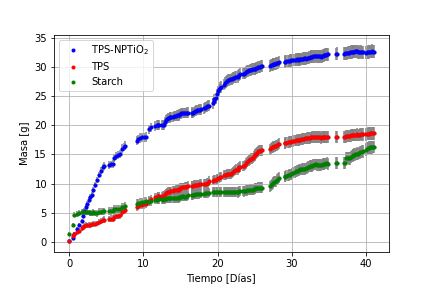
TEST3/co2_acumulado-sensor.png
