fyulita/laboratorio-6-y-7/WVP/resultado.png

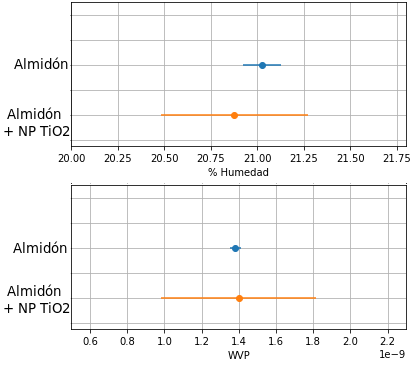
WVP/resultado.png
