fyulita/laboratorio-6-y-7/Arduino/measure-co2/measure-co2.ino

#include <Arduino.h>
#include <MHZ19.h>                                        
#include <SoftwareSerial.h>                                // Remove if using HardwareSerial

#define RX_PIN 8                                           // Rx pin which the MHZ19 Tx pin is attached to
#define TX_PIN 9                                           // Tx pin which the MHZ19 Rx pin is attached to
#define BAUDRATE 9600                                      // Device to MH-Z19 Serial baudrate (should not be changed)

MHZ19 myMHZ19;                                             // Constructor for library
SoftwareSerial mySerial(RX_PIN, TX_PIN);                   // (Uno example) create device to MH-Z19 serial

void setup() {
    Serial.begin(9600);                                     // Device to serial monitor feedback

    mySerial.begin(BAUDRATE);                               // (Uno example) device to MH-Z19 serial start
    myMHZ19.begin(mySerial);                                // *Serial(Stream) refence must be passed to library begin().

    myMHZ19.autoCalibration();                              // Turn auto calibration ON (OFF autoCalibration(false))

}

void loop() {
    /* note: getCO2() default is command "CO2 Unlimited". This returns the correct CO2 reading even 
    if below background CO2 levels or above range (useful to validate sensor). You can use the 
    usual documented command with getCO2(false) */
    Serial.println(myMHZ19.getCO2());
    
    delay(5000);
}
