fyulita/laboratorio-6-y-7/Arduino/measure-co2.py

import serial
import os
from datetime import datetime


arduino_port = "/dev/ttyUSB0"   # Serial port of Arduino
baud = 9600 # Arduino UNO runs at 9600 baud

ser = serial.Serial(arduino_port, baud)
print(f"Connected to Arduino port {arduino_port}")

now = datetime.now()
folder_name = now.strftime('%Y-%m-%d_%H-%M-%S')

os.makedirs(f"./measurements/CO2/{folder_name}")
print(f"Created folder {folder_name}")

measurement = 0 # Start at 0 because our header is 0 (not real data)
while True:
    if measurement % 100 == 0:
        fileName = f"./measurements/CO2/{folder_name}/data_{int(measurement / 100)}.csv"
        print(f"{fileName} created")
        file = open(fileName, "w")
        file.write("Date_Time,CO2\n")

    data = str(ser.readline())
    now = datetime.now()
    data = now.strftime("%d/%m/%Y_%H:%M:%S") + "," + data[2:-5] + "\n"
    print(data)

    file.write(data)    # Write data with a newline
    measurement += 1

    if measurement % 100 == 0 and measurement != 0:
        file.close()
        print(f"{fileName} completed")
