fyulita/laboratorio-6-y-7/(commit log)

2020-03-11 Cambie el README y el titulo del cuaderno.
2020-03-14 Agrego los pdfs que nos mando lucia para leer.
2020-03-23 Empece a escribir en el cuaderno con la reunion con Lucia.
2020-03-25 Agrego los macros de LyX.
2020-03-25 test de carolaina
2020-03-25 Borre el test de carolaina y agregue el mio.
2020-03-25 Edite el cuaderno.
2020-03-25 Cambie el archivo de LyX para que use los macros desde la carpeta de Material Adicional.
2020-03-26 Agrego el nuevo material de lectura.
2020-03-31 Agrego la propuesta de trabajo y la reemplazo en README.
2020-04-23 resumen de Kale
2020-04-24 Cambie el Sample de LyX.
2020-04-24 Agregue horarios excel.
    [Horarios.ods]
2020-04-28 Agregue lo que hablamos en la reunion al cuaderno.
2020-05-13 esquema experimental, precios y lugares donde comprar
    [Horarios.ods]
2020-05-13 lugares y precios de elelementos
2020-05-27 Revisado y emprolijado.
    [Horarios.ods]
2020-05-28 agregué una boludez de los frascos
2021-04-10 actualicé el cuaderno y agregué las facturas
2021-05-07 Agrego lo que hicimos con el arduino
2021-05-08 Avance con el Arduino
2021-05-13 Medicion de la temperatura
2021-06-01 Corregi algunas pavadas del cuaderno
    [Horarios.ods]
2021-06-02 Agrego el archivo de texto con las cosas que tenemos que decir en la charla con Silvia
2021-06-06 código para guardar la data
2021-06-07 Cambiamos el programa para el Arduino y para medir de Python
2021-06-08 Medición de T en el labo - 07/06
    [data_0.csv, data_1.csv, data_2.csv, data_3.csv]
2021-06-09 Agrego el paper que nos mando lucas sobre estandar de biodegradabilidad
2021-06-15 Agrego algunas mediciones del Arduino con el compost que dejamos en el labo y el cuaderno que hice
    [data_0.csv, data_1.csv, data_10.csv, data_11.csv, data_12.csv, data_13.csv, data_14.csv, data_15.csv]
2021-06-15 Borre algunas carpetas que no tenia que subir y agregue un .gitignore
2021-06-18 Agregue los datos que recuperamos de la compu antes de que se apague
    [data_100.csv, data_101.csv, data_102.csv, data_103.csv, data_104.csv, data_105.csv, data_106.csv, data_107.csv]
2021-06-18 Analice los nuevos datos y cambie el codigo de Python para que el Arduino no sobreescriba los datos
2021-06-29 Bajé los datos hasta 29/06 15.34 hs; 500 archivos
    [data_0.csv, data_1.csv, data_10.csv, data_100.csv, data_101.csv, data_102.csv, data_103.csv, data_104.csv]
2021-06-29 Agregue mediciones y cambie un poco el notebook para que sea mas comodo de usar con las mediciones separadas en carpetas
    [data_0.csv, data_1.csv, data_10.csv, data_100.csv, data_101.csv, data_102.csv, data_103.csv, data_104.csv]
2021-07-02 Agrego nuevas mediciones
    [data_0.csv, data_1.csv, data_10.csv, data_11.csv, data_12.csv, data_13.csv, data_14.csv, data_15.csv]
2021-07-08 Hice los graficos para las nuevas mediciones
2021-07-17 actualicé el cuaderno
2021-09-20 Add files via upload
    subo archivo de medicion de prueba de CO2
2021-09-20 Agrego un programa para medir y graficar las mediciones de CO2
    [medicion_0.csv]
2021-09-20 Actualizo el codigo de Arduino de CO2
2021-09-20 Agrego una medicion de CO2
    [data_0.csv, data_1.csv, data_2.csv, data_3.csv, data_4.csv, data_5.csv, data_6.csv, data_7.csv]
2021-09-20 Agrego las ultimas mediciones
    [data_0.csv, data_1.csv, data_10.csv, data_11.csv, data_12.csv, data_13.csv, data_14.csv, data_15.csv]
2021-09-22 Escribi el codigo para medir temperatura y CO2 controlando los relays
    [data_0.csv, data_1.csv, data_10.csv, data_100.csv, data_101.csv, data_102.csv, data_103.csv, data_104.csv]
2021-09-22 Corrijo algunos problemas del codigo
    [data_0.csv, data_1.csv, data_2.csv, data_3.csv, data_4.csv, data_5.csv, data_6.csv, data_7.csv]
2021-09-22 Actualizo el codigo
    [data_0.csv, data_1.csv, data_10.csv, data_100.csv, data_101.csv, data_102.csv, data_103.csv, data_104.csv]
2021-09-22 Actualice los cuadernos de Jupyter
    [data_0.csv, data_1.csv, data_2.csv, data_3.csv, data_4.csv, data_5.csv, data_6.csv, data_7.csv]
2021-09-27 Agrego un programa para medir las 4 series
2021-09-27 Corregi algunos errores del codigo
    [measure-all-x4.ino, measure-all-x4.py]
2021-09-29 Agregue el codigo para los otros tres termometros
2021-10-12 medicion de la cal sodada
2021-10-14 datos de la cal sodada
    [data_0.csv, data_1.csv, data_10.csv, data_11.csv, data_12.csv, data_13.csv, data_14.csv, data_15.csv]
2021-10-14 datos del CO2
    [data_0.csv]
2021-10-14 actualice el cuaderno
2021-10-18 Pequenos cambios en el labo
    [data_100.csv, data_101.csv, data_102.csv, data_103.csv, data_104.csv, data_105.csv, data_106.csv, data_107.csv]
2021-10-19 actualicé cuaderno WVP
    [data_WVP.csv]
2021-10-20 datos del martes 19/10
    [data_0.csv, data_1.csv, data_10.csv, data_11.csv, data_12.csv, data_13.csv, data_14.csv, data_15.csv]
2021-10-20 datos de la noche
    [data_71.csv, data_72.csv, data_73.csv]
2021-10-20 analisis de los datos de anoche
2021-10-20 mediciones del 20/10
    [data_0.csv, data_1.csv, data_10.csv, data_11.csv, data_12.csv, data_13.csv, data_14.csv, data_15.csv]
2021-10-20 observacion de los datos de la mañana del 20/10
2021-10-20 un dato que quedo suelto
    [data_17.csv]
2021-10-20 datos del 20/10
    [data_18.csv, data_19.csv, data_20.csv, data_21.csv, data_22.csv, data_23.csv, data_24.csv, data_25.csv]
2021-10-20 Borre las entradas basura en los ultimos datos
    [data_0.csv, data_1.csv, data_10.csv, data_11.csv, data_12.csv, data_13.csv, data_14.csv, data_15.csv]
2021-10-21 datos de la noche 20/10
    [data_0.csv, data_1.csv, data_10.csv, data_11.csv, data_12.csv, data_13.csv, data_14.csv, data_15.csv]
2021-10-21 datos del 21/10
    [data_0.csv, data_1.csv, data_10.csv, data_11.csv, data_12.csv, data_13.csv, data_14.csv, data_15.csv]
2021-10-22 Medi con el raspberry
    [data_0.csv, data_1.csv, data_2.csv, data_3.csv]
2021-10-23 Agregue pesos para WVP
    [data_0.csv, data_WVP.csv]
2021-10-23 mediciones del 23/0 con raspberry
    [data_0.csv, data_1.csv, data_2.csv, data_3.csv, data_4.csv, data_5.csv, data_6.csv, data_7.csv]
2021-10-24 datos de la noche del 23/10
    [data_10.csv, data_100.csv, data_101.csv, data_102.csv, data_103.csv, data_104.csv, data_105.csv, data_106.csv]
2021-10-24 datos de la noche 23/10
    [data_0.csv, data_WVP.csv]
2021-10-24 Revise el cuaderno y actualice los graficos
2021-10-24 datos 24/10
    [data_124.csv, data_125.csv, data_126.csv, data_127.csv, data_128.csv, data_129.csv, data_130.csv, data_131.csv]
2021-10-24 dato perdido
    [data_124.csv]
2021-10-24 Agregue las ultimas mediciones y actualice el cuaderno
    [data_137.csv, data_138.csv, data_139.csv, data_140.csv, data_141.csv, data_142.csv, data_143.csv, data_144.csv]
2021-10-24 datos y prueba del 24/10
    [data_137.csv, data_138.csv, data_139.csv, data_140.csv, data_141.csv, data_142.csv, data_143.csv, data_144.csv]
2021-10-25 datos de la noche del 24/10
    [data_0.csv, data_1.csv, data_10.csv, data_11.csv, data_12.csv, data_13.csv, data_14.csv, data_15.csv]
2021-10-25 Actualizo con todos los datos
    [data_0.csv, data_1.csv, data_10.csv, data_11.csv, data_12.csv, data_13.csv, data_14.csv, data_15.csv]
2021-10-26 mediciones de la noche del 25/10
    [data_0.csv, data_1.csv, data_10.csv, data_11.csv, data_12.csv, data_13.csv, data_14.csv, data_15.csv]
2021-10-27 datos del 26/10
    [data_0.csv, data_1.csv, data_10.csv, data_100.csv, data_101.csv, data_102.csv, data_103.csv, data_104.csv]
2021-10-27 observacion de datos del 26/10 y WV10 y WVP
    [data_0.csv, data_1.csv, data_10.csv, data_11.csv, data_12.csv, data_13.csv, data_14.csv, data_15.csv]
2021-10-27 datos de la noche del 26/10 y edité te el notebook
    [data_0.csv, data_1.csv, data_10.csv, data_11.csv, data_12.csv, data_13.csv, data_14.csv, data_15.csv]
2021-10-27 Actualizo las ultimas mediciones
    [data_0.csv, data_51.csv, data_52.csv, data_53.csv, data_54.csv, data_55.csv, data_56.csv, data_57.csv]
2021-10-28 Pese las muestras de WVP y titule los NaOH
    [data_WVP_10-27.csv]
2021-10-28 datos de la noche del 27/10
    [data_0.csv, data_1.csv, data_10.csv, data_100.csv, data_101.csv, data_102.csv, data_103.csv, data_104.csv]
2021-10-28 datos hasta las 14:20hs del 28/10
    [data_0.csv, data_1.csv, data_10.csv, data_100.csv, data_101.csv, data_102.csv, data_103.csv, data_104.csv]
2021-10-28 cosas del 28/10
    [data_0.csv, data_1.csv, data_2.csv, data_3.csv, data_4.csv, data_5.csv, data_6.csv, data_7.csv]
2021-10-29 graficos del WVP
    [data_WVP.csv, data_WVP_impares.csv, data_WVP_impares2.csv, data_WVP_pares.csv]
2021-11-04 datos salvados, provisorios del dia 1
    [data_0.csv, data_1.csv, data_10.csv, data_11.csv, data_12.csv, data_13.csv, data_14.csv, data_15.csv]
2021-11-05 datos salvados de la noche del día 1, y titulación
    [data.csv, data_100.csv, data_101.csv, data_102.csv, data_103.csv, data_104.csv, data_105.csv, data_106.csv]
2021-11-05 Agrego las mediciones del experimento oficial hasta data_253.csv
    [data_0.csv, data_1.csv, data_10.csv, data_100.csv, data_101.csv, data_102.csv, data_103.csv, data_104.csv]
2021-11-05 Agrego mediciones y agrego titulaciones del dia
    [data.csv, data_0.csv, data_1.csv, data_10.csv, data_100.csv, data_101.csv, data_102.csv, data_103.csv]
2021-11-05 Agregue las ultimas mediciones con la danza
    [data_0.csv, data_1.csv, data_10.csv, data_11.csv, data_12.csv, data_2.csv, data_3.csv, data_4.csv]
2021-11-08 datos del finde
    [data_0.csv, data_1.csv, data_10.csv, data_100.csv, data_101.csv, data_102.csv, data_103.csv, data_104.csv]
2021-11-08 edité el notebook-all-x4, agregué el cálculo de áreas
2021-11-08 Corregi un par de huevadas del cuaderno
2021-11-08 Agregue un script para copiar todas las mediciones oficiales a una sola carpeta
    [data_0.csv, data_1.csv, data_10.csv, data_100.csv, data_101.csv, data_102.csv, data_103.csv, data_104.csv]
2021-11-09 un poco de analisis
    [area_2021-11-03_17-49-11.csv, area_2021-11-05_16-07-41.csv, area_2021-11-05_18-09-50.csv, data.csv, data_0.csv, data_1.csv, data_2.csv, data_278.csv]
2021-11-10 Agrego todas las mediciones
    [data_0.csv, data_1.csv, data_10.csv, data_100.csv, data_101.csv, data_102.csv, data_103.csv, data_104.csv]
2021-11-25 datos hasta el 24/11
    [area_2021-11-17_19-34-49.csv, area_2021-11-19_17-55-37.csv, data_0.csv, data_1.csv, data_10.csv, data_100.csv, data_101.csv, data_102.csv]
2021-11-26 Actualizo el README
2021-11-29 actualizacion de datos
    [area_2021-11-19_17-55-37.csv, area_2021-11-27_16-16-53.csv, area_2021-11-27_18-22-19.csv, data_0.csv, data_1.csv, data_10.csv, data_100.csv, data_1000.csv]
2021-12-09 analisis de la última semana de medición - CHOCLAZO CON LOS DATOS
    [area_2021-11-27_18-22-19-EDITADO.csv, areas_0-280.csv, areas_1135-1163.csv, areas_1180-1200.csv, areas_1222-1237.csv, areas_280-525.csv, areas_525-569.csv, areas_525-580.csv]
2021-12-15 analisis de la humedad y WVP juntos
2021-12-16 Actualizo los requirements para python
2021-12-16 Hice la comparacion de los graficos
2022-03-17 Edito los scripts de measure-all-x4 para que usen la mitad de las valvulas
2022-03-24 Actualización de datos - Test #3
    [data_0.csv, data_1.csv, data_10.csv, data_11.csv, data_12.csv, data_13.csv, data_14.csv, data_15.csv]
2022-03-26 TEST 3: Actualización de datos
    [data_0.csv, data_1.csv, data_10.csv, data_100.csv, data_101.csv, data_102.csv, data_103.csv, data_104.csv]
2022-03-27 Arregle los scripts y mediciones
    [data_100.csv, data_101.csv, data_102.csv, data_103.csv, data_104.csv, data_105.csv, data_106.csv, data_107.csv]
2022-03-30 subo datos hasta el 29/03 a la noche
    [data_0.csv, data_1.csv, data_10.csv, data_100.csv, data_101.csv, data_102.csv, data_103.csv, data_104.csv]
2022-03-30 junto datos en Test3
    [promedio_1.csv, promedio_2.csv, promedio_3.csv, promedio_4.csv, promedio_5.csv, promedio_6.csv, promedio_std_1.csv, promedio_std_2.csv]
2022-03-30 subo datos de hasta el mediodia del 30/03
    [data_0.csv, data_242.csv, data_243.csv, data_244.csv, data_245.csv, data_246.csv, data_247.csv, data_248.csv]
2022-03-30 grafico TGA
    [promedio.csv, promedio_std.csv]
2022-04-02 Subo datos hasta el 02/04 a la tarde
    [data_0.csv, data_1.csv, data_10.csv, data_11.csv, data_12.csv, data_13.csv, data_14.csv, data_15.csv]
2022-04-03 Arregle el codigo para que ignore los strings raros en mediciones de co2 y para que renombre las columnas que estaban rotas
    [data_0.csv, data_1.csv, data_10.csv, data_100.csv, data_101.csv, data_102.csv, data_103.csv, data_104.csv]
2022-04-04 datos hasta el 03/04
    [data_0.csv, data_1.csv, data_10.csv, data_11.csv, data_12.csv, data_13.csv, data_14.csv, data_15.csv]
2022-04-05 subo datos del lunes 04/04
    [data_0.csv, data_1.csv, data_10.csv, data_11.csv, data_12.csv, data_13.csv, data_14.csv, data_15.csv]
2022-04-05 levanto curva de biodeg hasta día 7
    [data_0.csv, data_1.csv, data_10.csv, data_100.csv, data_101.csv, data_102.csv, data_103.csv, data_104.csv]
2022-04-06 subo datos de hasta el 06/04 al mediodia
    [data_0.csv, data_1.csv, data_10.csv, data_100.csv, data_101.csv, data_102.csv, data_103.csv, data_104.csv]
2022-04-07 subo datos hasta 06/04 entero
    [data_100.csv, data_101.csv, data_102.csv, data_103.csv, data_104.csv, data_105.csv, data_106.csv, data_107.csv]
2022-04-07 subo datos hasta el 06/04 entero
    [data_158.csv]
2022-04-07 levanto curva de biodeg
    [data_0.csv, data_1.csv, data_10.csv, data_100.csv, data_101.csv, data_102.csv, data_103.csv, data_104.csv]
2022-04-07 subo los datos de la madrugada 07/04
    [data_159.csv, data_160.csv, data_161.csv, data_162.csv, data_163.csv, data_164.csv, data_165.csv, data_166.csv]
2022-04-08 subo mediciones hasta 08/04 mediodia
    [data_0.csv, data_1.csv, data_10.csv, data_11.csv, data_12.csv, data_13.csv, data_14.csv, data_15.csv]
2022-04-08 actualizo curva de biodeg
    [data_0.csv, promedio.csv, promedio_17.csv, promedio_18.csv, promedio_std.csv, promedio_std_17.csv, promedio_std_18.csv]
2022-04-10 subo datos de hasta el domingo 10/04
    [data_0.csv, data_1.csv, data_10.csv, data_100.csv, data_101.csv, data_102.csv, data_103.csv, data_104.csv]
2022-04-11 subo datos de hasta domingo 10/04 a la noche
    [data_0.csv, data_100.csv, data_101.csv, data_102.csv, data_103.csv, data_104.csv, data_105.csv, data_106.csv]
2022-04-11 actualizo curva biodeg
    [promedio.csv, promedio_15.csv, promedio_16.csv, promedio_19.csv, promedio_20.csv, promedio_std.csv, promedio_std_15.csv, promedio_std_16.csv]
2022-04-15 subo datos de hasta el viernes 15/04
    [data_0.csv, data_1.csv, data_10.csv, data_100.csv, data_101.csv, data_102.csv, data_103.csv, data_104.csv]
2022-04-18 subo datos hasta el 18/04
    [data_10.csv, data_100.csv, data_101.csv, data_102.csv, data_103.csv, data_104.csv, data_105.csv, data_106.csv]
2022-04-21 subo datos hasta el 21/04
    [data_0.csv, data_1.csv, data_10.csv, data_100.csv, data_101.csv, data_102.csv, data_103.csv, data_104.csv]
2022-04-23 subo datos hasta el 22/04
    [data_0.csv, data_1.csv, data_10.csv, data_100.csv, data_101.csv, data_102.csv, data_103.csv, data_104.csv]
2022-04-28 subo datos hasta 28/04
    [data_0.csv, data_1.csv, data_10.csv, data_100.csv, data_101.csv, data_102.csv, data_103.csv, data_104.csv]
2022-05-15 subo ultimos datos!
    [data_0.csv, data_1.csv, data_10.csv, data_100.csv, data_101.csv, data_102.csv, data_103.csv, data_104.csv]
2022-05-15 analizo datos
    [data_0.csv, data_1.csv, data_10.csv, data_11.csv, data_12.csv, data_2.csv, data_3.csv, data_4.csv]
